cansat-tsniimash/CanSat-KT315-2022/Documents/Models/Frames/tip-open_0070.jpg

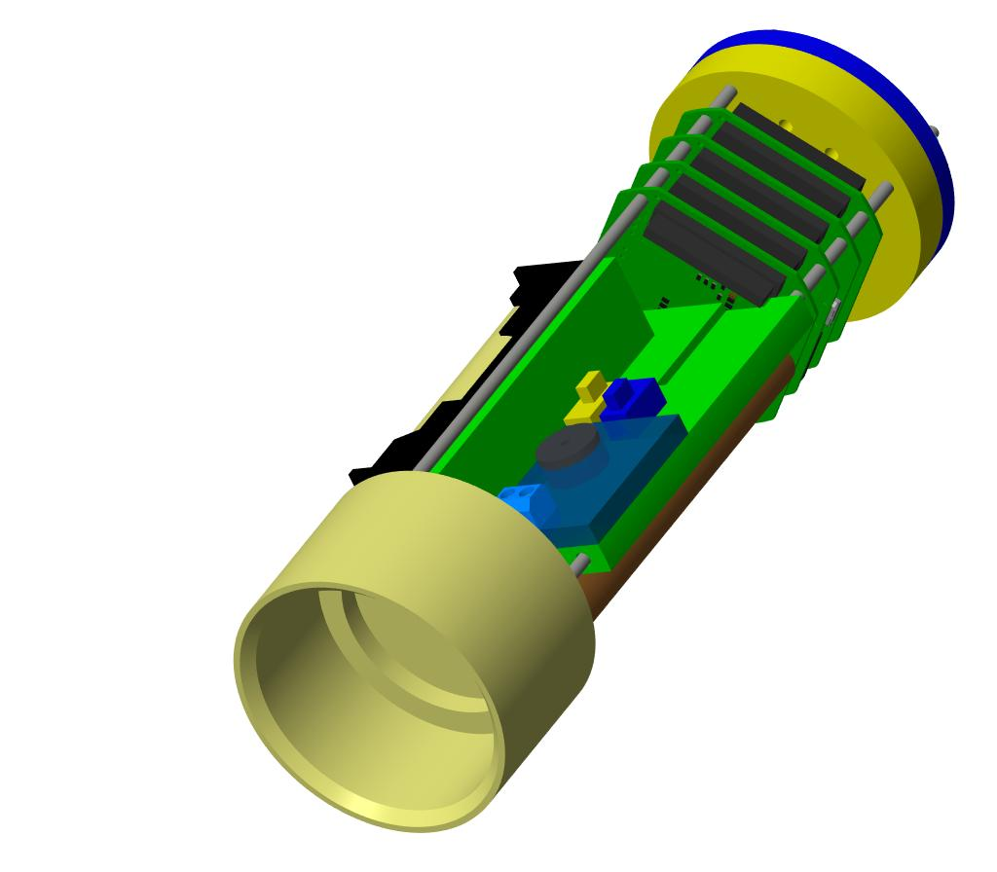
Documents/Models/Frames/tip-open_0070.jpg
