cansat-tsniimash/CanSat-KT315-2022/Documents/Session/onewire_.pdf

# Обмен цифровой информацией

# Шины и интерфейсы

## Знакомство с инструментами и мигание лампочкой

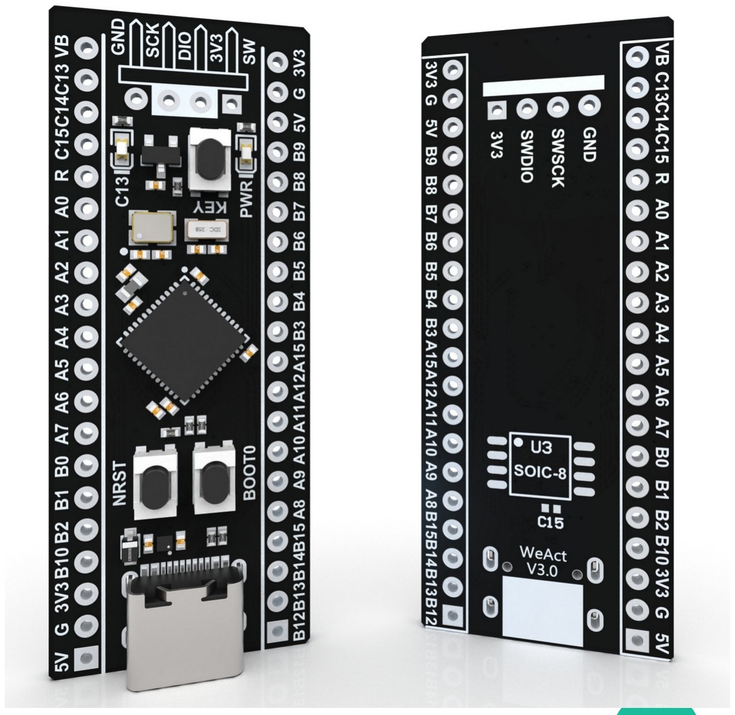
[picture p2: figure]

3

# Плата WeActTC/MiniSTM32F4x1

# - У нас вариант с STM32F411CEU6 на борту - Плата имеет документацию! https://github.com/WeActTC/ MiniSTM32F4x1 (https://github.com/WeActTC/MiniSTM32F4x1)

# Что есть на плате

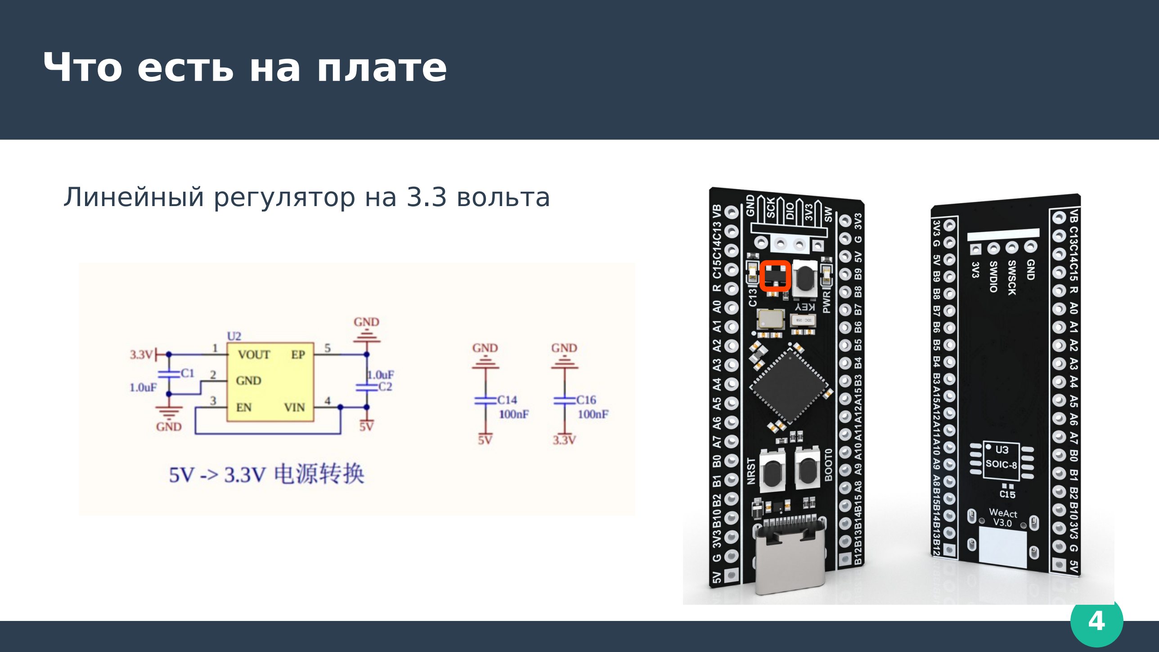
[picture p3: page 4]

4

# Линейный регулятор на 3.3 вольта

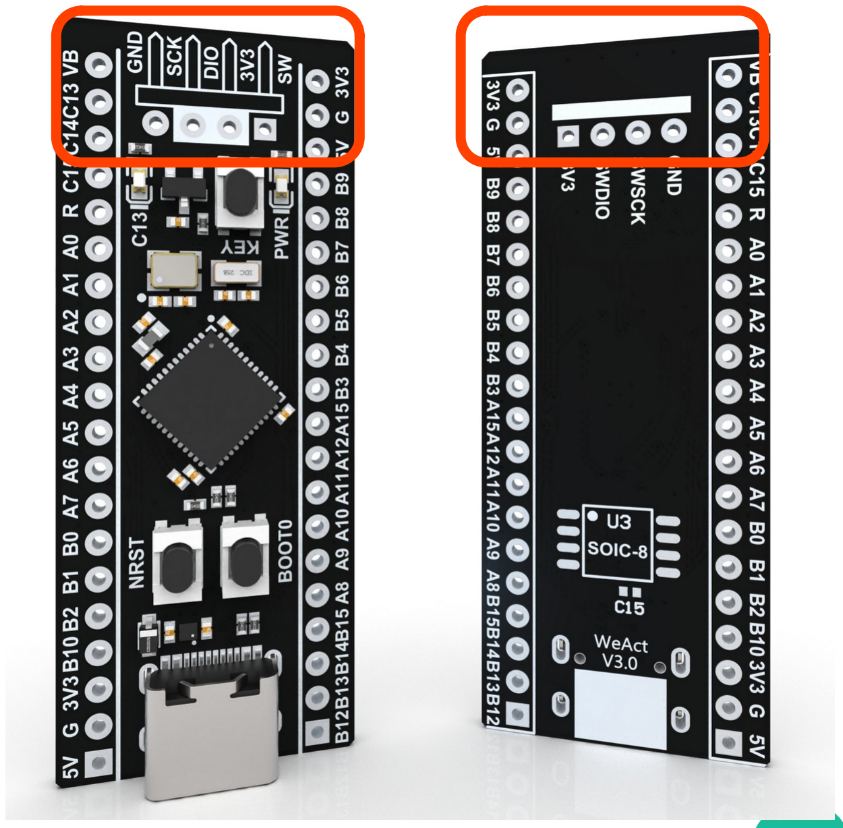
[picture p4: figure]

5

# Что есть на плате

# Разъем для программатора (Serial Wire Debug = SWD)

# 3V3 — питание 3.3В GND — нулевой провод (земля) SCK — синхросигнал SWD DIO — данные SWD

# Что есть на плате

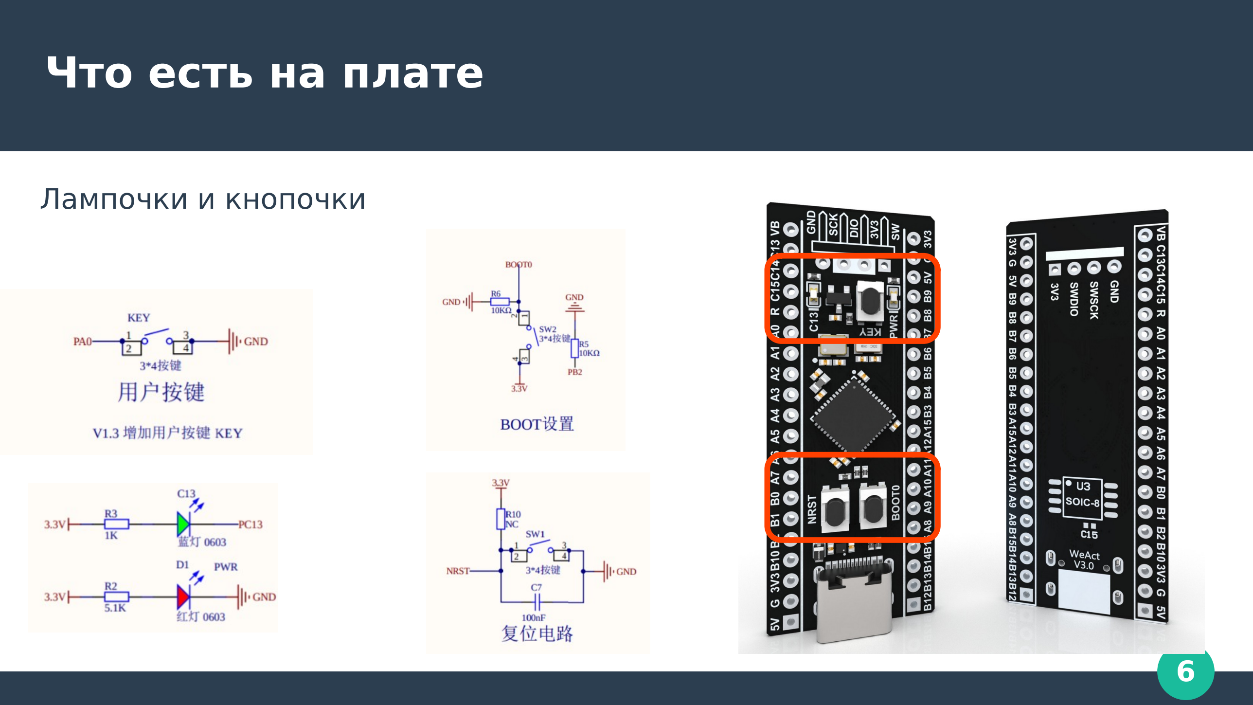
[picture p5: page 6]

6

# Лампочки и кнопочки

# Что есть на плате

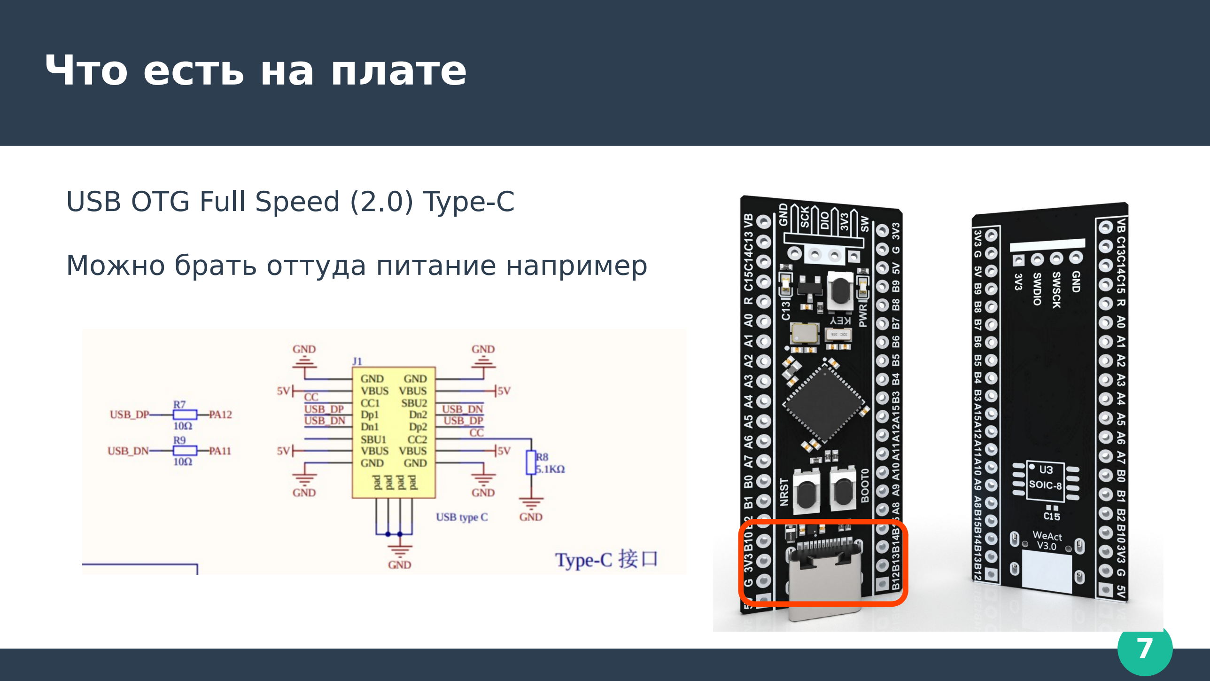
[picture p6: page 7]

7

# USB OTG Full Speed (2.0) Type-C

# Можно брать оттуда питание например

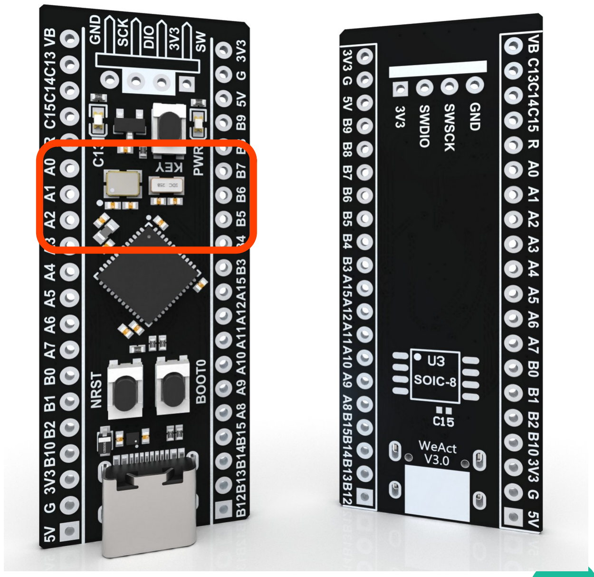
[picture p7: figure]

8

# Что есть на плате

# Кварцевые резонаторы

# HSE (High Speed External) на 25 МГц LSE (Low Speed External) на 32.768 КГц

# Что есть на плате

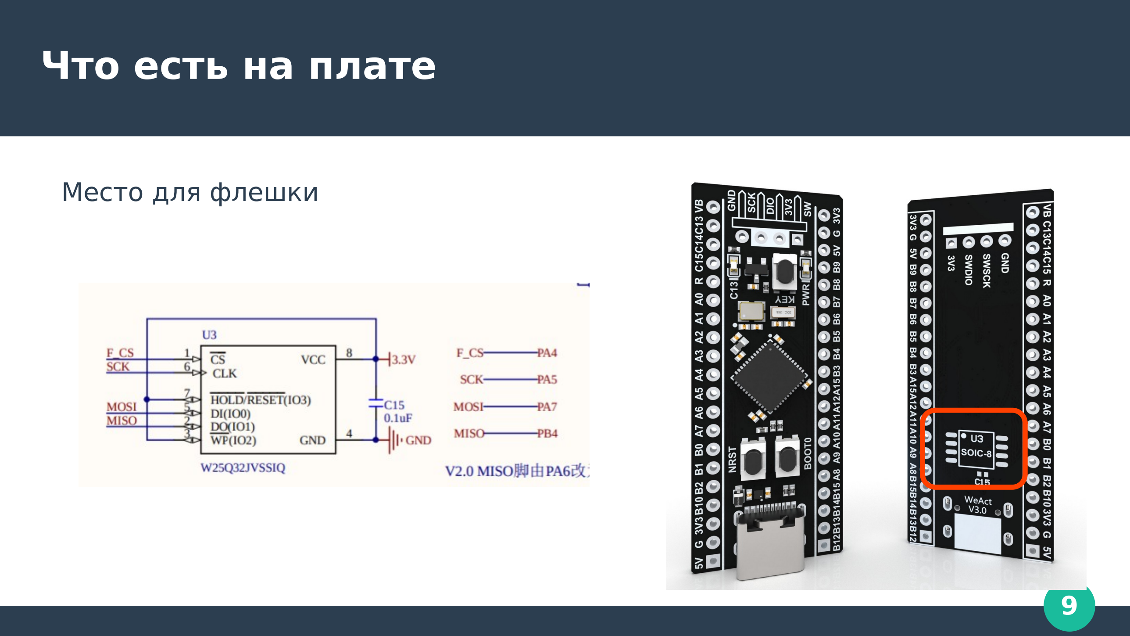
[picture p8: page 9]

9

# Место для флешки

10

# STM32CubeIDE

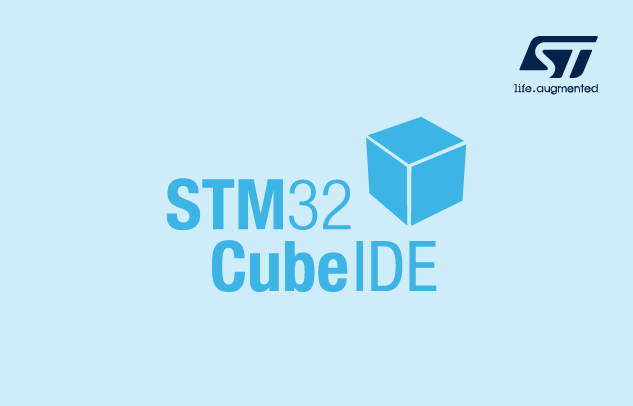
[picture p9: figure]

11

# Создание проекта

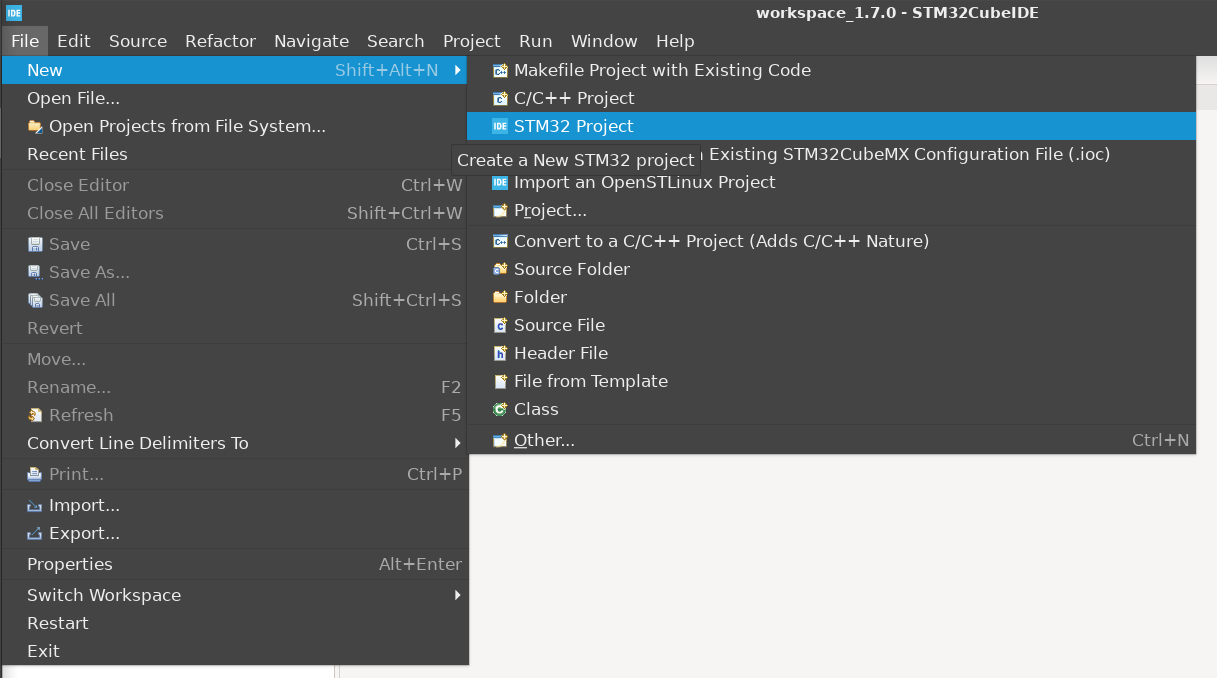
[picture p10: figure]

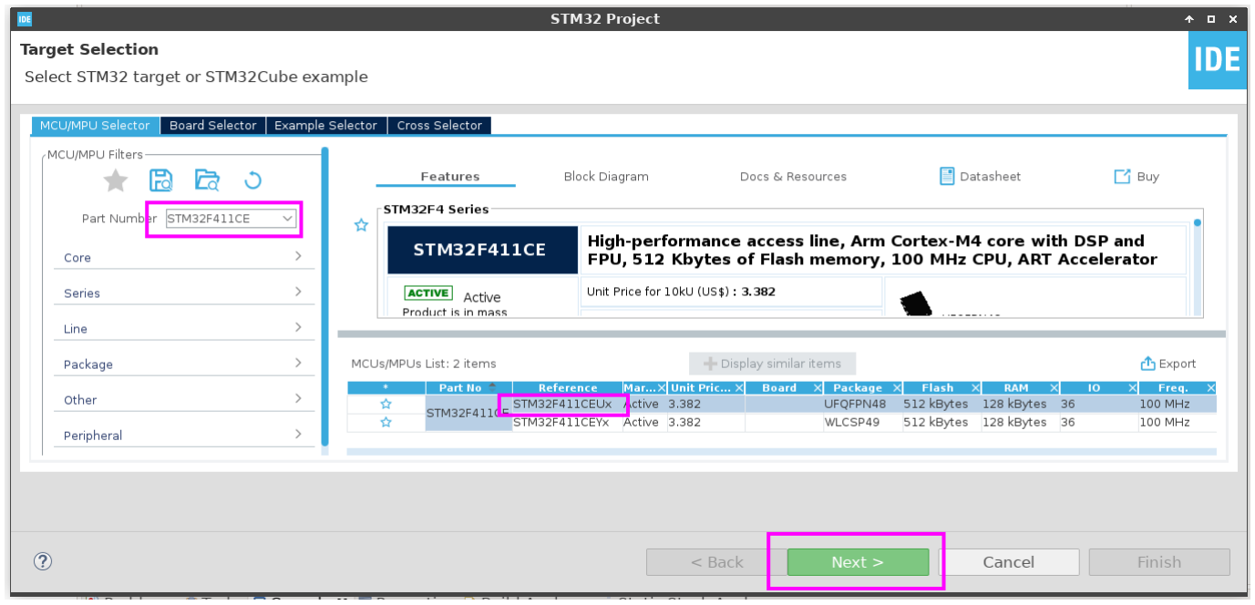
[picture p11: figure]

12

# Создание проекта

# Создание проекта

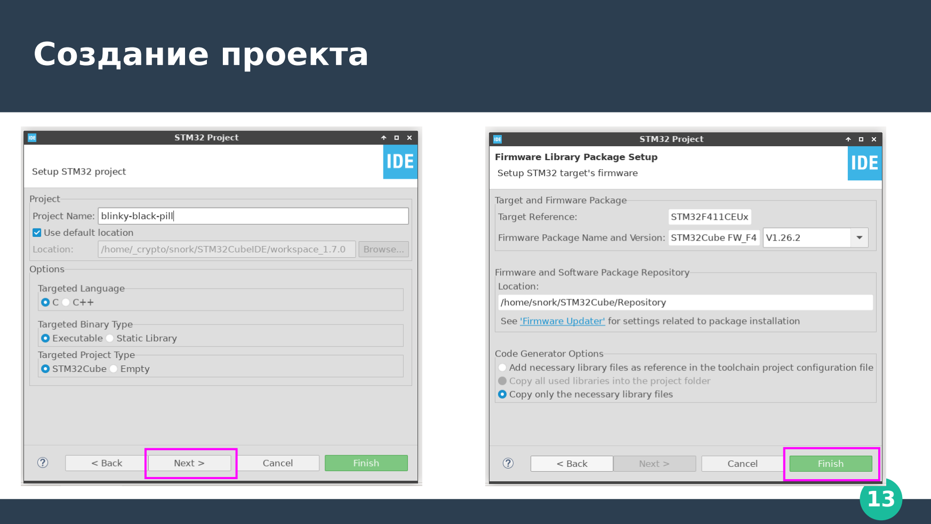
[picture p12: page 13]

13

14

# Обзор проекта

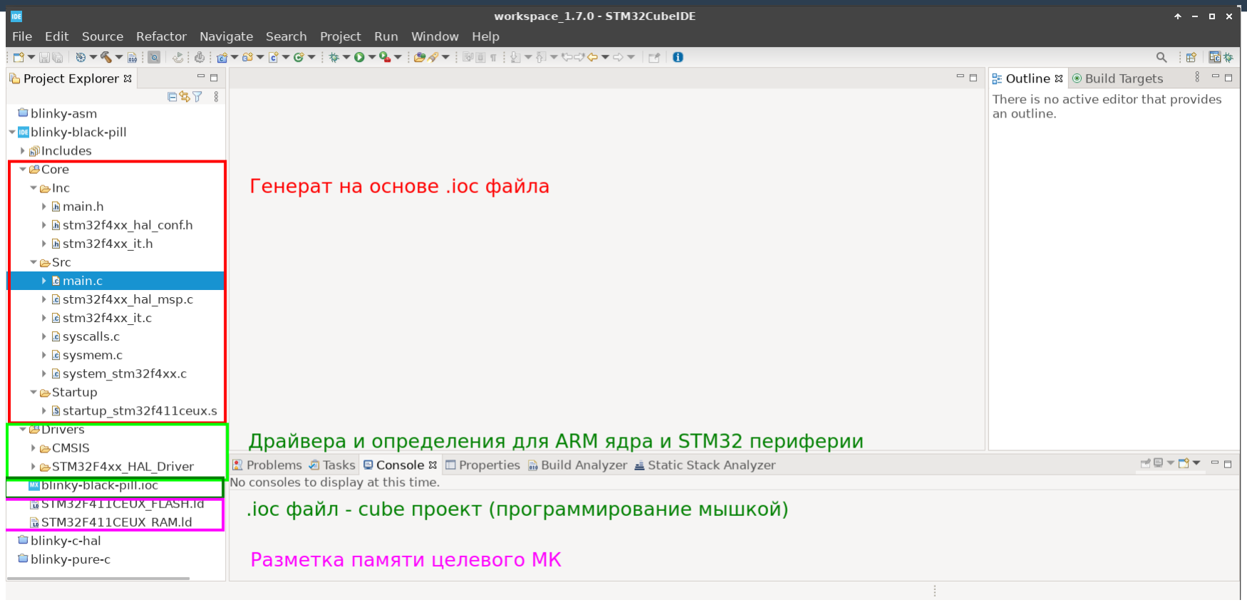
[picture p13: figure]

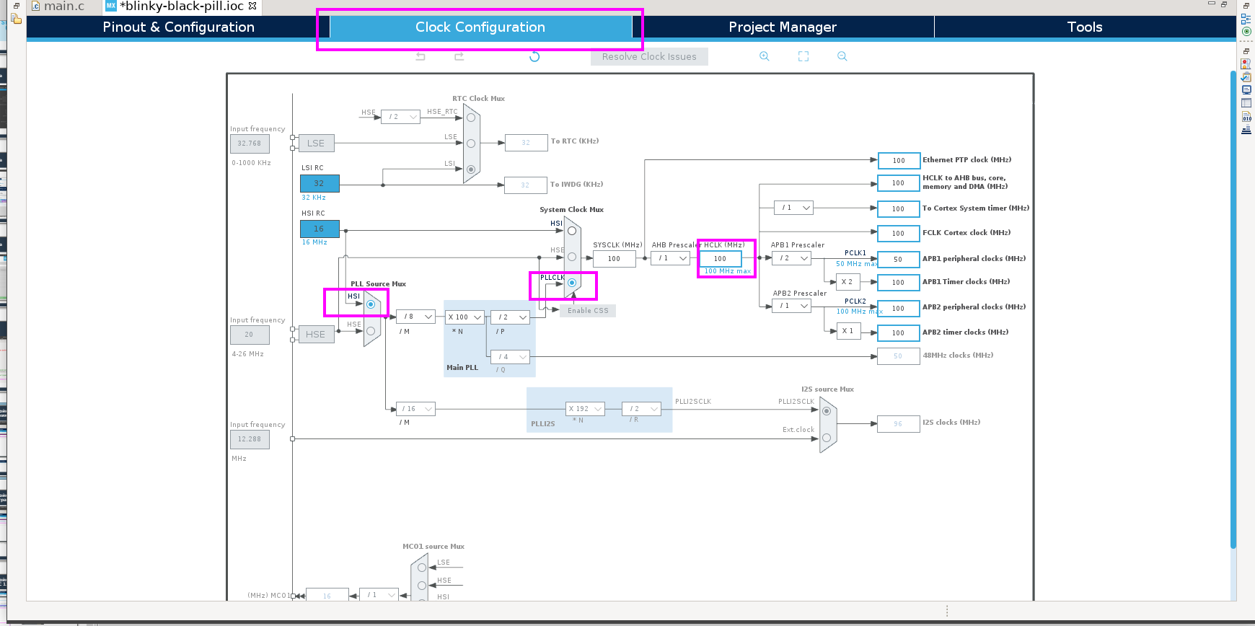
[picture p14: figure]

15

# Первичная настройка Cube (.ioc) проекта Настройка частот

16

# Первичная настройка Cube (.ioc) проекта Разрешение программатора

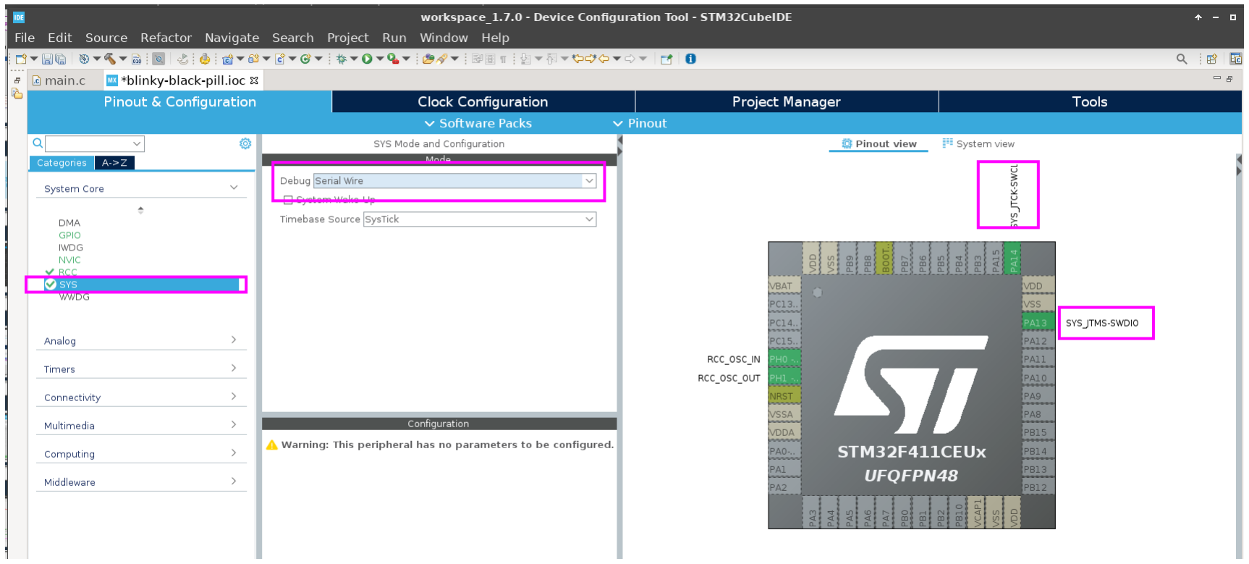
[picture p15: figure]

# Первичная настройка Cube (.ioc) проекта Настройка GPIO C 13

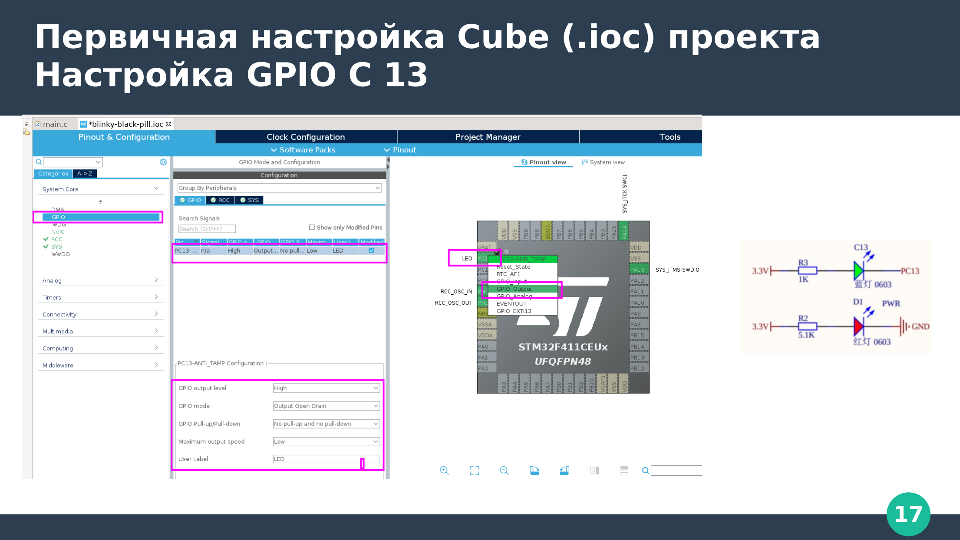
[picture p16: page 17]

17

# Push Pull / Open Drain

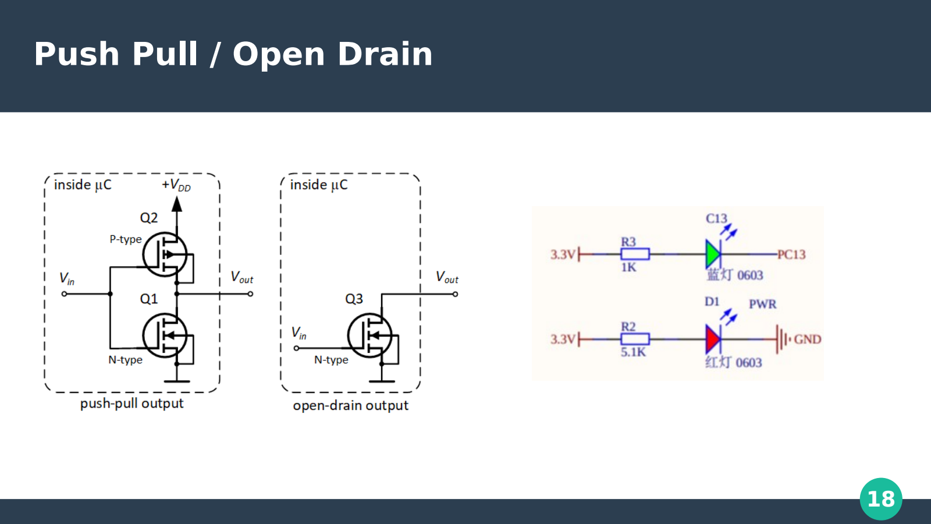
[picture p17: page 18]

18

# Обновление генерата

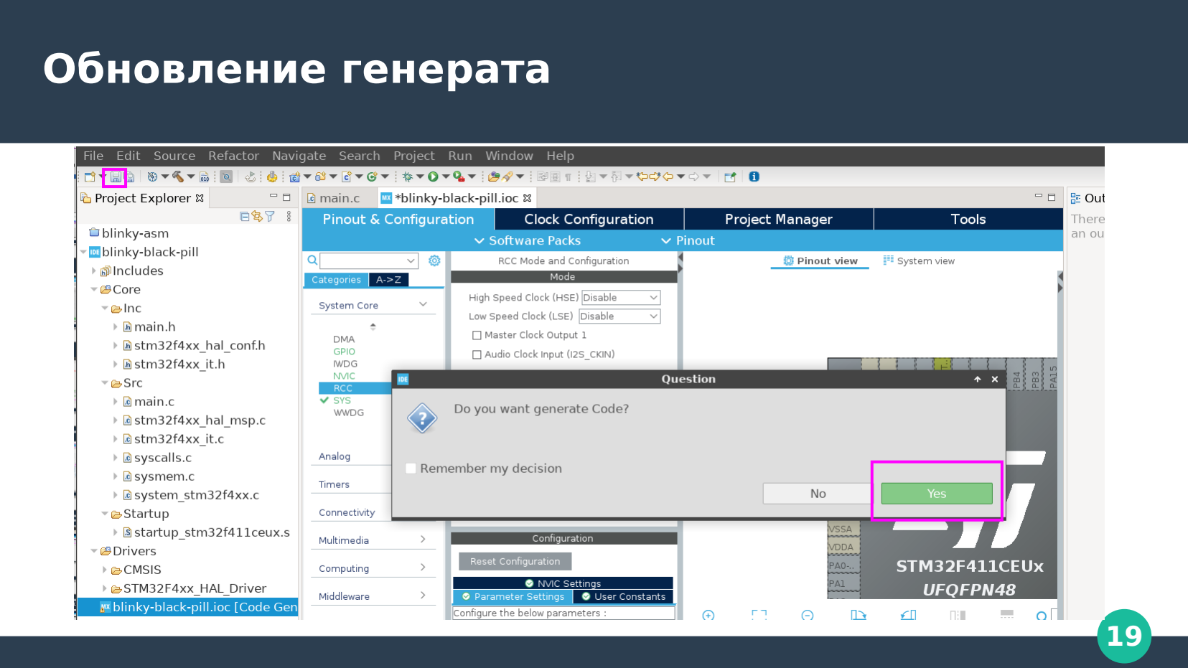
[picture p18: page 19]

19

20

# Функция main()

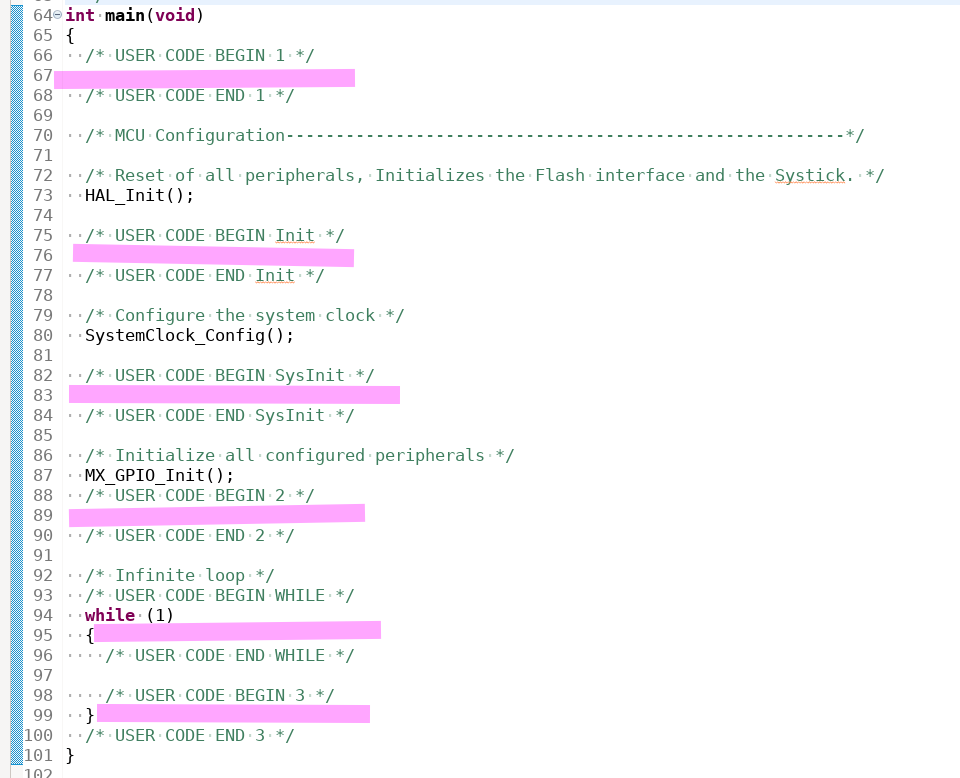
[picture p19: figure]

# Состоит из инициализации железа и бесконечного цикла

21

# Функции для работы с GPIO

Вообще, документация для HAL живёт тут, (https://www.st.com/resource/en/user_manual/dm00105879-description-of-stm32f4-hal-and-ll-drivers-stmicroelectronics.pdf) но это большой и сложный

# документ. Почти все что в нем написано — написано и в исходниках

/* Initialization and de-initialization functions *****************************/
void HAL_GPIO_Init(GPIO_TypeDef *GPIOx, GPIO_InitTypeDef *GPIO_Init);
void HAL_GPIO_DeInit(GPIO_TypeDef *GPIOx, uint32_t GPIO_Pin);

/* IO operation functions *****************************************************/ GPIO_PinState HAL_GPIO_ReadPin(GPIO_TypeDef* GPIOx, uint16_t GPIO_Pin);
void HAL_GPIO_WritePin(GPIO_TypeDef* GPIOx, uint16_t GPIO_Pin, GPIO_PinState PinState); void HAL_GPIO_TogglePin(GPIO_TypeDef* GPIOx, uint16_t GPIO_Pin);

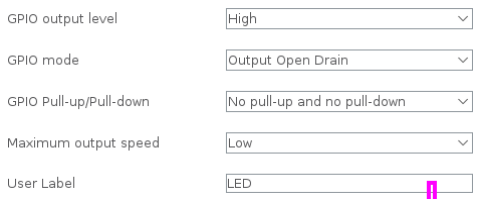
[picture p20: figure]

22

# Что нагенерил cube для инициализации?

static void MX_GPIO_Init(void)
{
GPIO_InitTypeDef GPIO_InitStruct = {0};

/* GPIO Ports Clock Enable */ __HAL_RCC_GPIOC_CLK_ENABLE(); __HAL_RCC_GPIOA_CLK_ENABLE();

/*Configure GPIO pin Output Level */ HAL_GPIO_WritePin(LED_GPIO_Port, LED_Pin, GPIO_PIN_SET);

/*Configure GPIO pin : LED_Pin */
GPIO_InitStruct.Pin = LED_Pin;
GPIO_InitStruct.Mode = GPIO_MODE_OUTPUT_OD; GPIO_InitStruct.Pull = GPIO_NOPULL; GPIO_InitStruct.Speed = GPIO_SPEED_FREQ_LOW; HAL_GPIO_Init(LED_GPIO_Port, &GPIO_InitStruct);

}

/* Private defines -----------------------------------------------------------*/ #define LED_Pin GPIO_PIN_13
#define LED_GPIO_Port GPIOC

# Фаил main.h

# Фаил main.c

23

# Мигаем лампочкой

/* Infinite loop */
/* USER CODE BEGIN WHILE */ while (1)
{
// Зажигаем лампочку
HAL_GPIO_WritePin(GPIOC, GPIO_PIN_13, GPIO_PIN_RESET); // Ждем 1000 миллисекунд
HAL_Delay(1000);
// Тушим лампочку
HAL_GPIO_WritePin(LED_GPIO_Port, LED_Pin, GPIO_PIN_SET); // Ждем 500 миллисекунд
HAL_Delay(500);
/* USER CODE END WHILE */

/* USER CODE BEGIN 3 */
}
/* USER CODE END 3 */

# Фаил main.c функция main(void)

# Сборка проекта

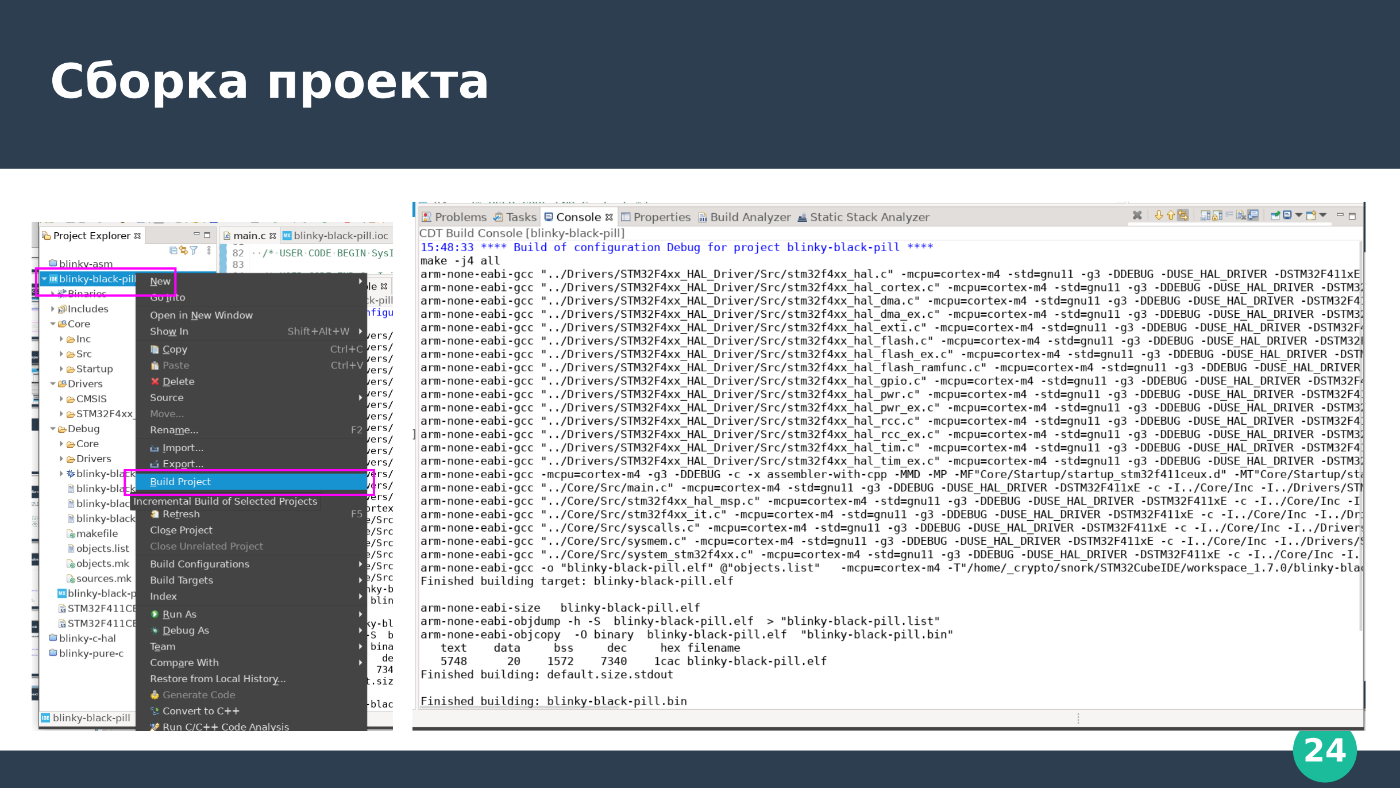
[picture p21: page 24]

24

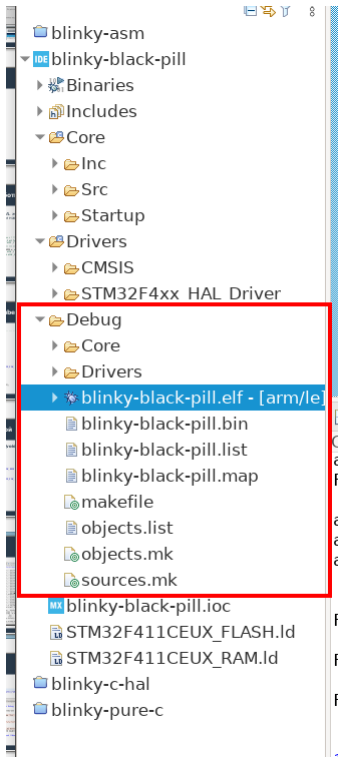
[picture p22: figure]

25

# Результаты сборки

# .elf файл — Executable and Linkable Format

Формат .exe файла для POSIX платформ.

# Содержит все необходимое для запуска и отладки проекта

# .bin — образ флеш памяти целевого МК

# .list — asm листинг получившегося кода

# .map — файл-карта. Показывает в какие регионы памяти попали разные функции и переменные

26

# Cборка проекта неудачный билд

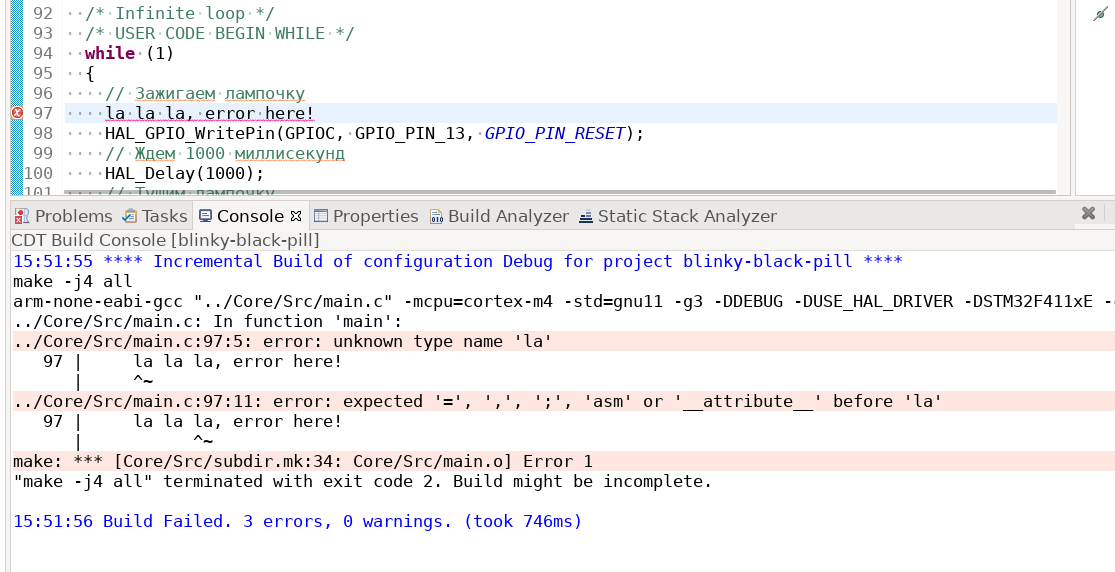
[picture p23: figure]

27

# Прошивка проекта Создание конфигурации запуска

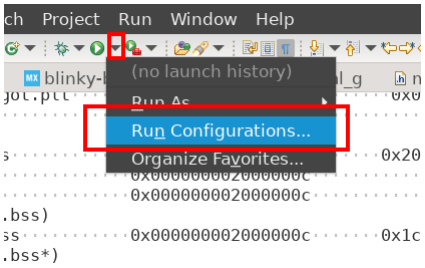
[picture p24: figure]

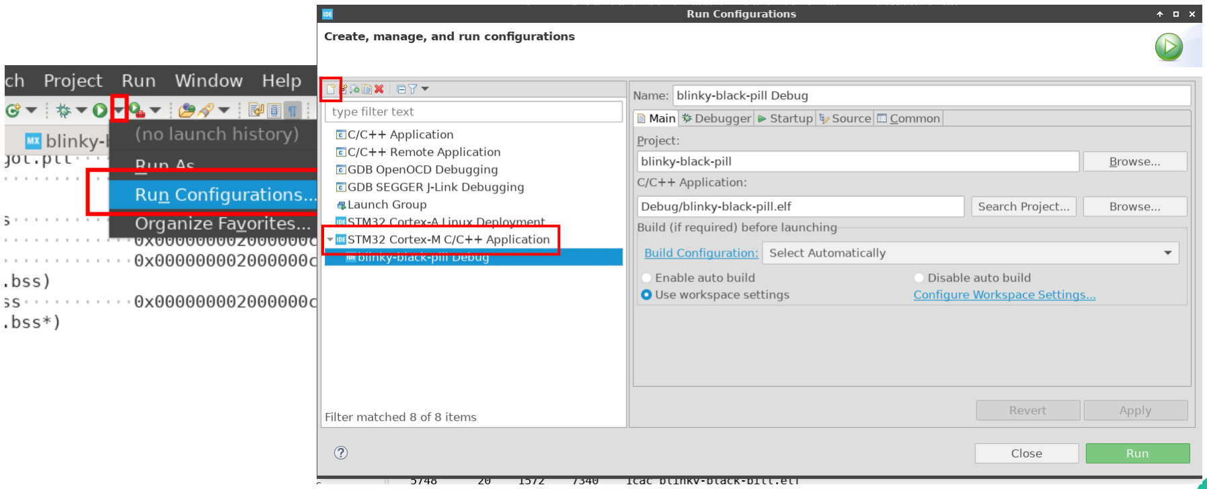
[picture p25: figure]

28

# Прошивка проекта Создание конфигурации запуска

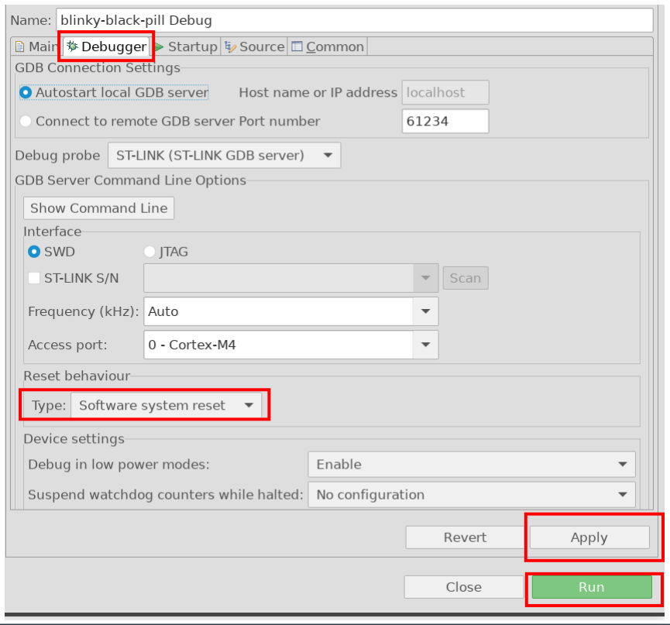
[picture p26: figure]

29

# Прошика проекта Настройка конфигурации запуска

# Прошивка проекта Подключение программатора и запуск

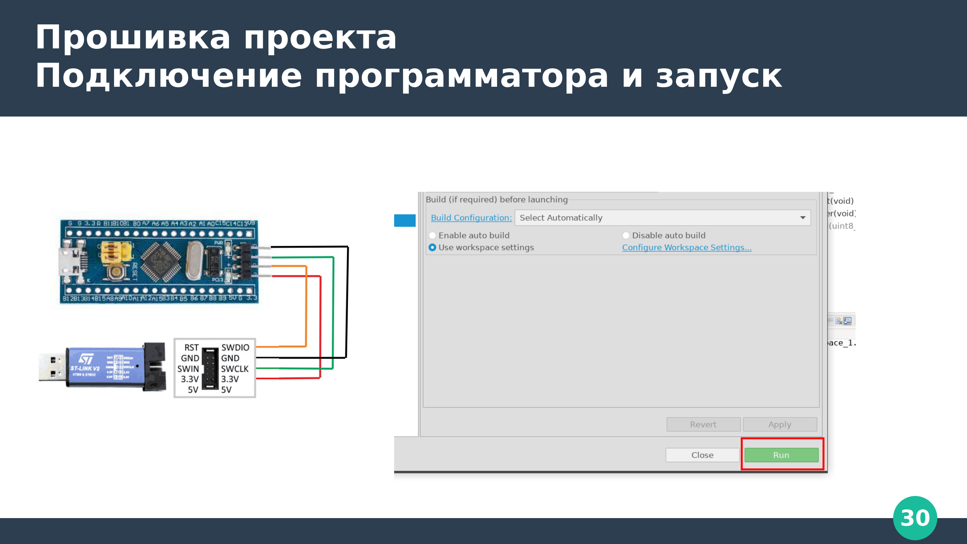
[picture p27: page 30]

30

## Делаем себе консоль

32

# UART

# Universal asynchronous receiver-transmitter

# Асинхронный интерфейс

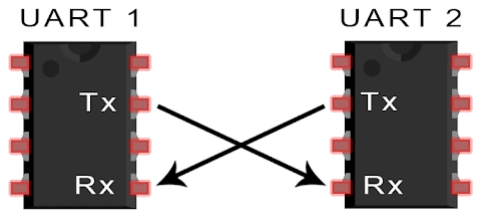
[picture p28: figure]

# Позволяет связать два равноправных устройства

# Достаточно быстрый

# Очень распространённый

33

# UART

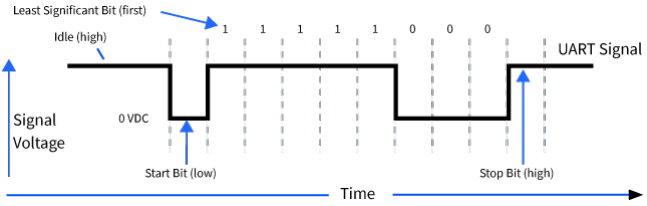
[picture p29: figure]

34

# UART Baud Rate

# Baud Rate это частота изменения сигнала. Показывает сколько

«символов» в секунду передается посредством интерфейса. Типовые значения: 110, 300, 600, 1200, 2400, 4800, 9600, 14400, 19200, 38400, 57600, 115200, 128000 и 256000

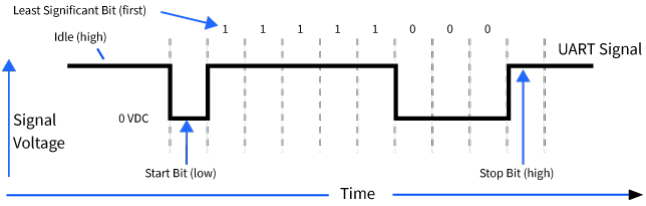
[picture p30: figure]

35

# UART Word size

# В этом примере передаётся 8 бит за один «фрейм». Некоторые

устройства передают большее или меньшее количество бит за фрейм.

# UART Parity

# Возможно использование специального «бита чётности». Этот бит

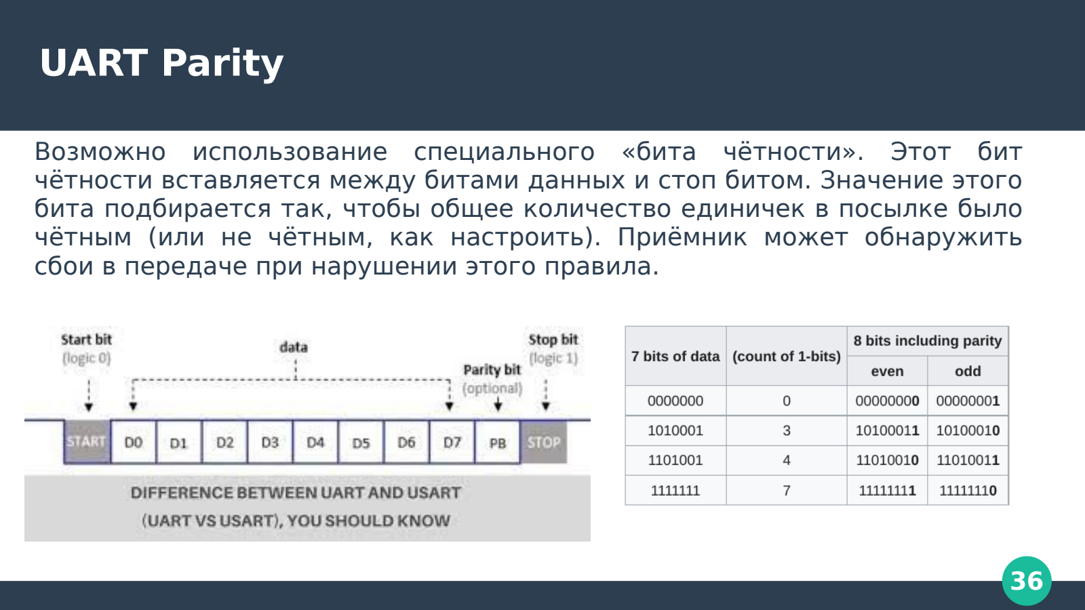
[picture p31: page 36]

36

# чётности вставляется между битами данных и стоп битом. Значение этого бита подбирается так, чтобы общее количество единичек в посылке было чётным (или не чётным, как настроить). Приёмник может обнаружить

сбои в передаче при нарушении этого правила.

37

# UART Stop Bits

# В этом примере используется 1 стоп бит. Некоторые устройства используют несколько стоп битов

38

# В нашем stm32 есть аж 3 U(S)ART модуля периферии

# Включаем U(S)ART1

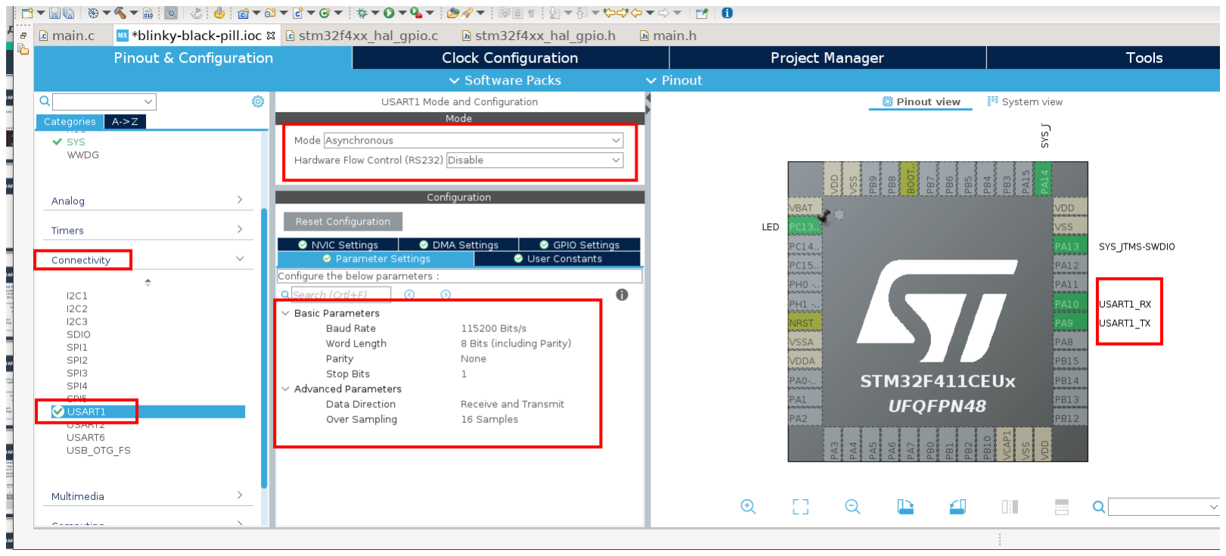
[picture p32: figure]

39

# API для работы с U(S)ART

# API для работы с U(S)ART

/* Initialization/de-initialization functions **********************************/ HAL_StatusTypeDef HAL_UART_Init(UART_HandleTypeDef *huart);

HAL_StatusTypeDef HAL_HalfDuplex_Init(UART_HandleTypeDef *huart);
HAL_StatusTypeDef HAL_LIN_Init(UART_HandleTypeDef *huart, uint32_t BreakDetectLength);
HAL_StatusTypeDef HAL_MultiProcessor_Init(UART_HandleTypeDef *huart, uint8_t Address, uint32_t WakeUpMethod); HAL_StatusTypeDef HAL_UART_DeInit(UART_HandleTypeDef *huart);

/* IO operation functions *******************************************************/
HAL_StatusTypeDef HAL_UART_Transmit(UART_HandleTypeDef *huart, uint8_t *pData, uint16_t Size, uint32_t Timeout); HAL_StatusTypeDef HAL_UART_Receive(UART_HandleTypeDef *huart, uint8_t *pData, uint16_t Size, uint32_t Timeout);

HAL_StatusTypeDef HAL_UART_Transmit_IT(UART_HandleTypeDef *huart, uint8_t *pData, uint16_t Size);
HAL_StatusTypeDef HAL_UART_Receive_IT(UART_HandleTypeDef *huart, uint8_t *pData, uint16_t Size);
HAL_StatusTypeDef HAL_UART_Transmit_DMA(UART_HandleTypeDef *huart, uint8_t *pData, uint16_t Size);
HAL_StatusTypeDef HAL_UART_Receive_DMA(UART_HandleTypeDef *huart, uint8_t *pData, uint16_t Size);

40

# Отправляем hello world

/* USER CODE BEGIN 2 */
const char string[] = "Hello world!\n"; /* USER CODE END 2 */

/* Infinite loop */
/* USER CODE BEGIN WHILE */
while (1)
{
// Зажигаем лампочку
HAL_GPIO_WritePin(GPIOC, GPIO_PIN_13, GPIO_PIN_RESET); // Ждем 1000 миллисекунд
HAL_Delay(1000);
// Тушим лампочку
HAL_GPIO_WritePin(LED_GPIO_Port, LED_Pin, GPIO_PIN_SET); // Ждем 500 миллисекунд
HAL_Delay(500);

// Отправляем хеллоу ворлд
HAL_UART_Transmit(&huart1, string, sizeof(string)-1, HAL_MAX_DELAY);

/* USER CODE END WHILE */

/* USER CODE BEGIN 3 */
}
/* USER CODE END 3 */

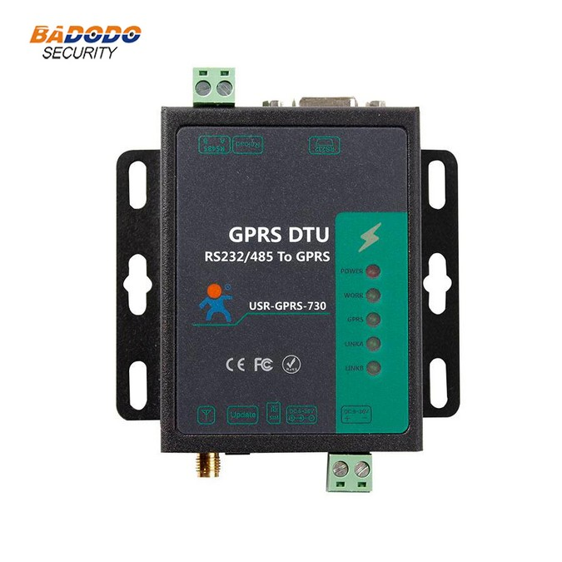
[picture p33: figure]

41

# Принимаем сообщение на ПК

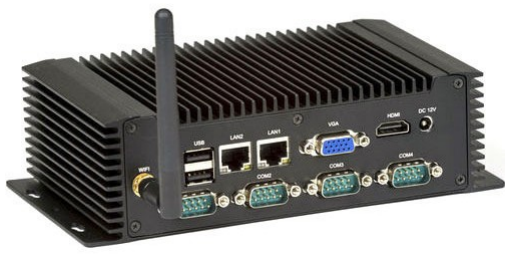
[picture p34: figure]

# RS-232 традиционно использовался на ПК для подключения различной

периферии.

# Сейчас он присутствует на многих материнских платах, но не выведен на корпус. На корпус он выведен в

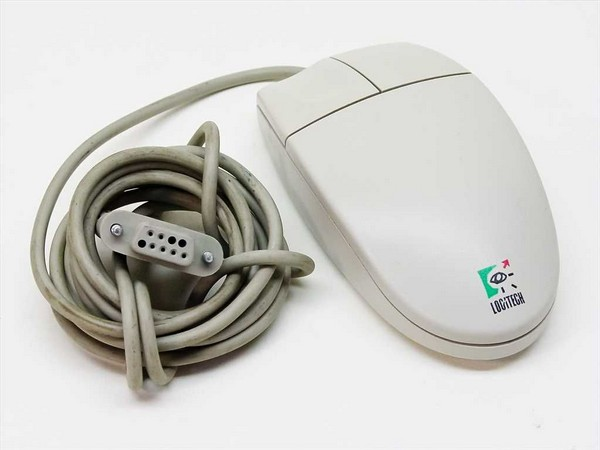
[picture p35: figure]

# промышленных ПК (например в кассовых аппаратах)

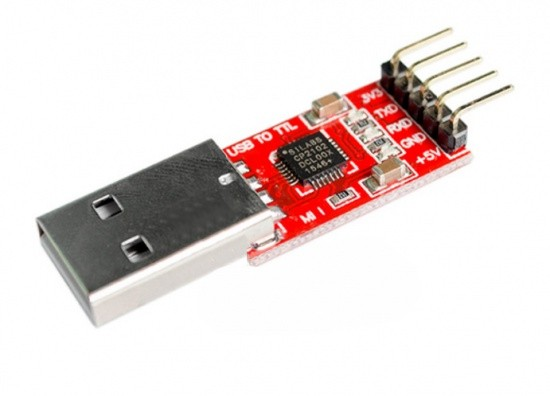
[picture p36: figure]

42

# USB-UART преобразователь

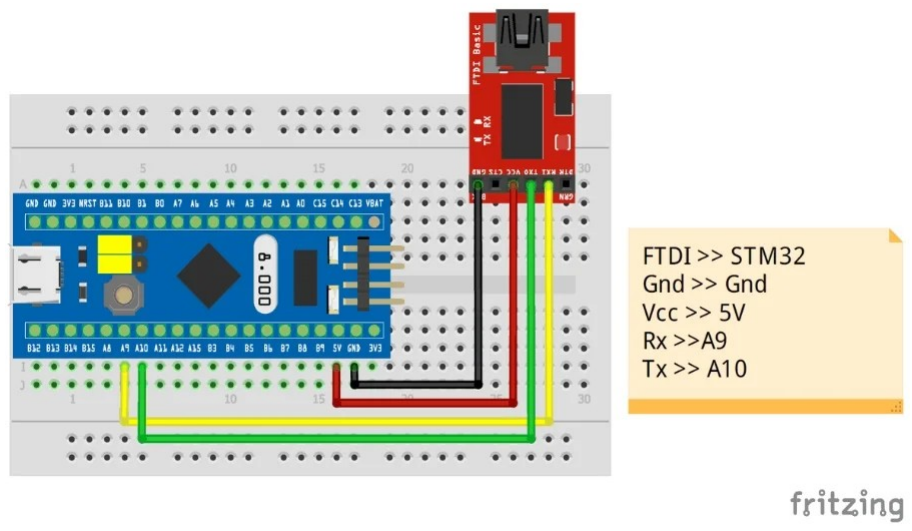
[picture p37: figure]

43

# Подключение к STM32

# Putty / minicom

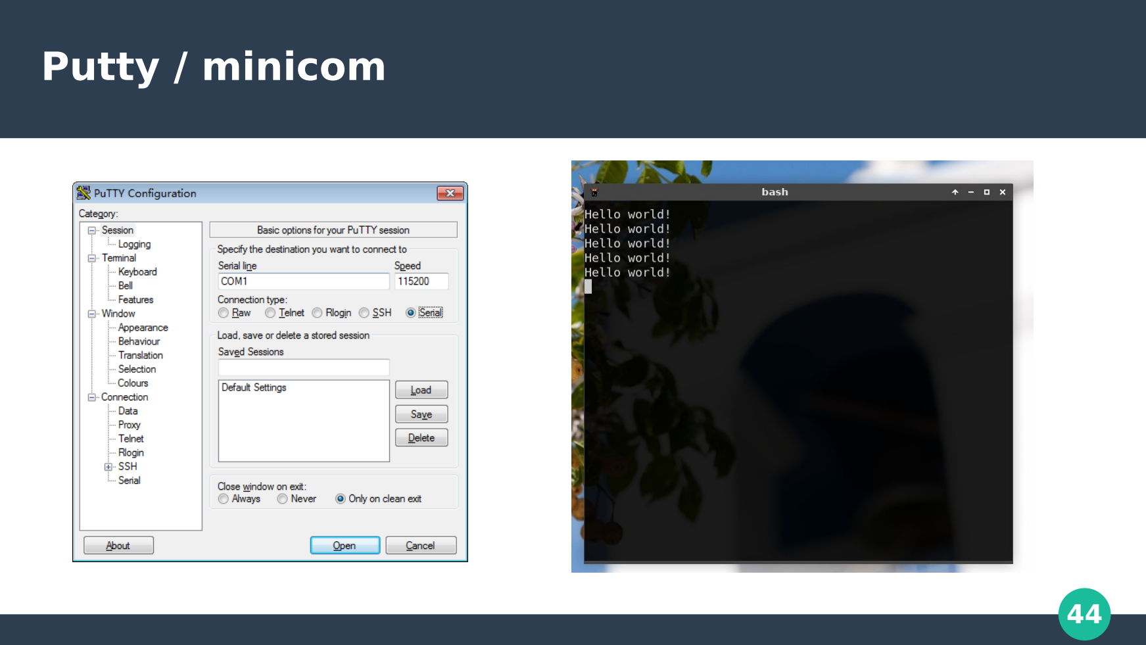
[picture p38: page 44]

44

# Использование UART вместе с printf

# Стандартная библиотека Си (newlib)

# Пользовательское приложение

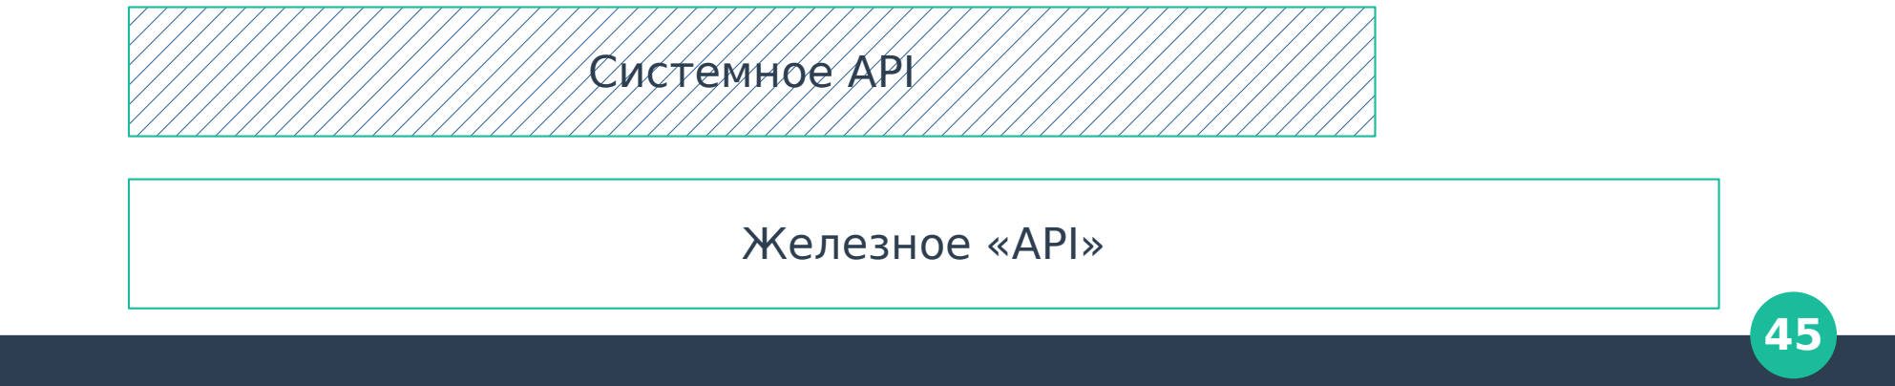
[picture p39: figure]
Системное API; Железное «API»

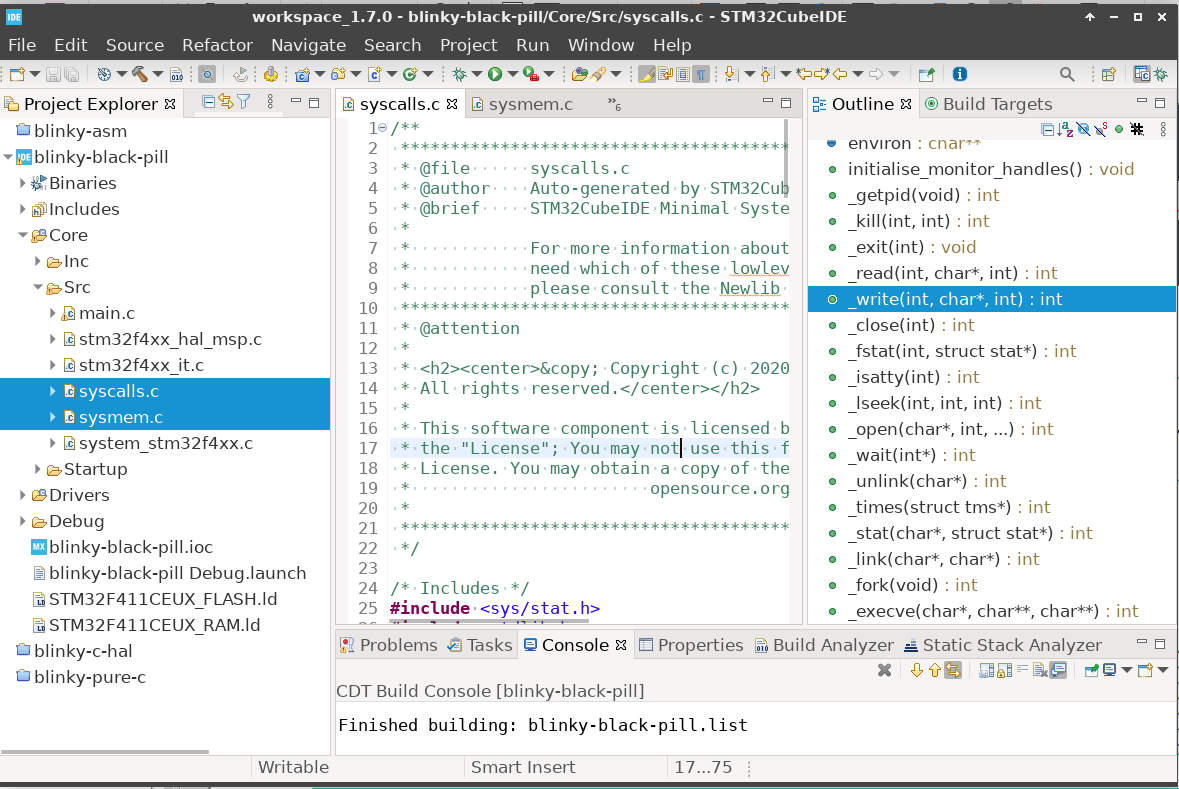
[picture p40: figure]

46

# Использование UART вместе с printf

int _write(int file, char *ptr, int len) {
/* … */
}

#include <stm32f4xx_hal.h>

int _write(int file, char *ptr, int len) {
extern UART_HandleTypeDef huart1;

HAL_UART_Transmit(
&huart1,
(uint8_t*)ptr, len,
HAL_MAX_DELAY
);

return len;
}

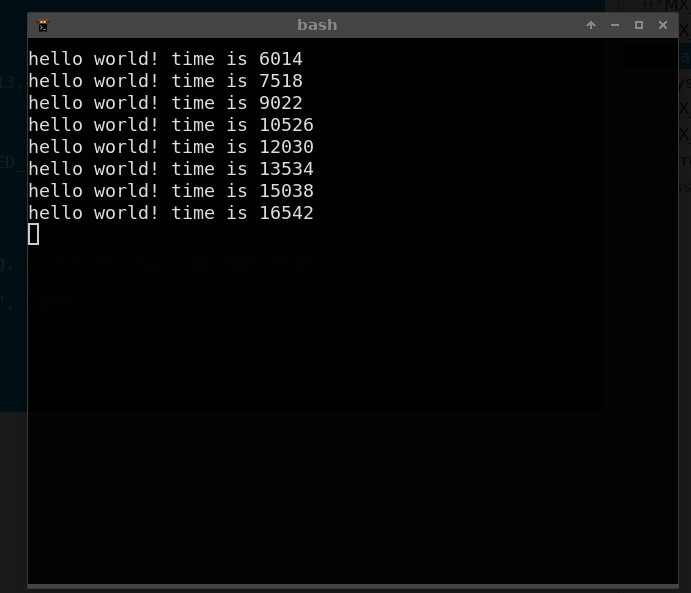
[picture p41: figure]

47

# Каноничный hello world

/* Private includes ----------------------------------------------------------*/ /* USER CODE BEGIN Includes */
#include <stdio.h>

/* USER CODE END Includes */ | /* USER CODE BEGIN WHILE */
| while (1)
| {
| // Зажигаем лампочку
| HAL_GPIO_WritePin(GPIOC, GPIO_PIN_13, GPIO_PIN_RESET);
| // Ждем 1000 миллисекунд
| HAL_Delay(1000);
| // Тушим лампочку
| HAL_GPIO_WritePin(LED_GPIO_Port, LED_Pin, GPIO_PIN_SET);
| // Ждем 500 миллисекунд
| HAL_Delay(500);
| // Отправляем хеллоу ворлд
| //HAL_UART_Transmit(&huart1, string, sizeof(string), HAL_MAX_DELAY);
| int32_t time = HAL_GetTick();
| printf("hello world! time is %ld\n", time);
| /* USER CODE END WHILE */
| /* USER CODE BEGIN 3 */
| }
| /* USER CODE END 3 */

## Шина OneWire

49

# Шина 1-Wire

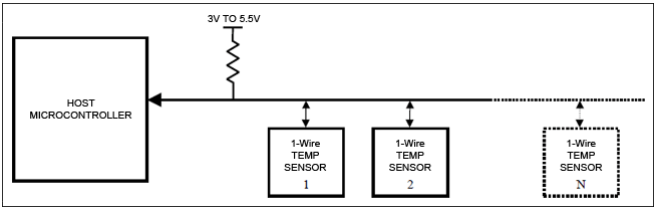
[picture p42: figure]

# Чумовой туториал на русском (https://aterlux.ru/article/1wire)

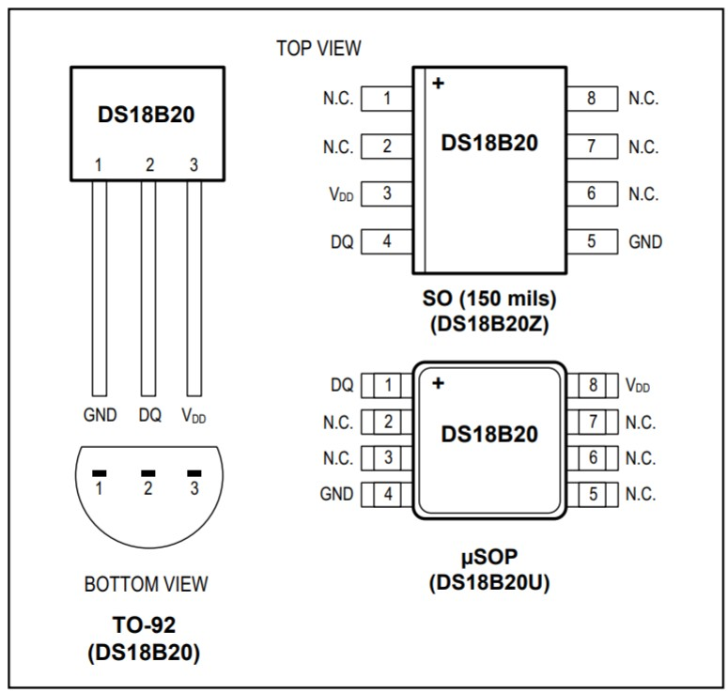
[picture p43: figure]

50

# DS18B20

# - Measures Temperatures from -55°C to

+125°C

- ±0.5°C Accuracy from -10°C to +85°C - Programmable Resolution from 9 Bits to 12 Bits - No External Components Required - Parasitic Power Mode Requires Only 2 Pins for operation (DQ and GND) - Flexible User-Definable Nonvolatile (NV) Alarm Settings with Alarm Search Command Identifies Devices with Temperatures Outside Programmed Limits

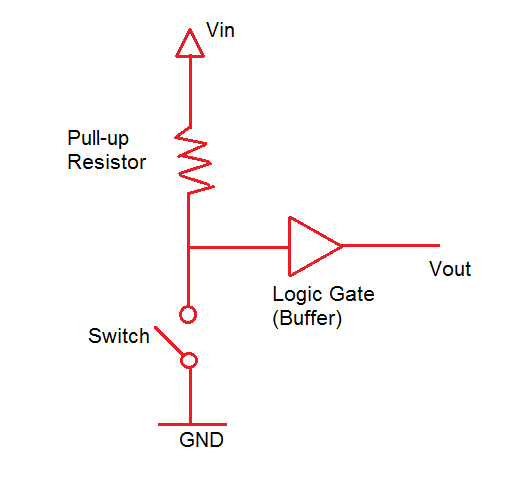
[picture p44: figure]

51

# Резистор подтяжки. 0 и 1 на шине

52

# Передача битиков от ведущего

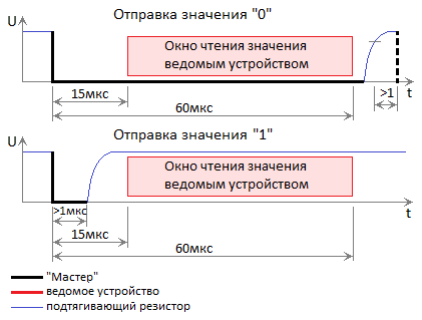
[picture p45: figure]

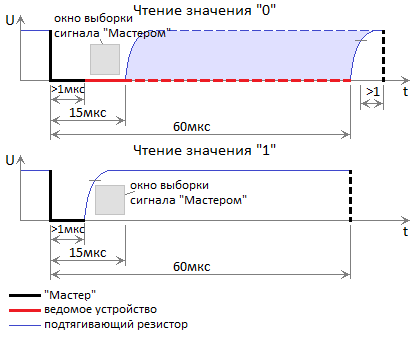
[picture p46: figure]

53

# Передача битиков от ведомого

54

# Этапы обмена

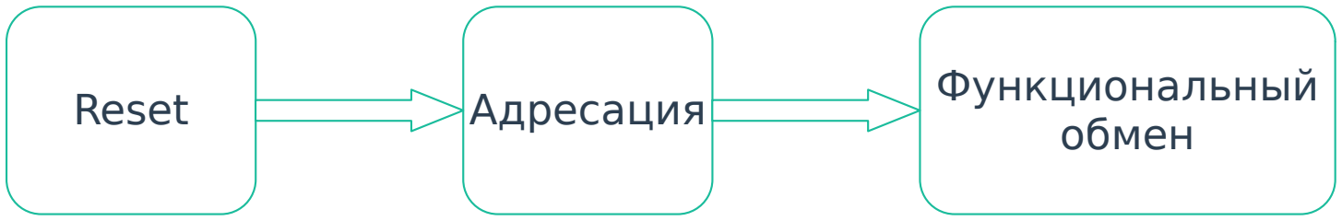
[picture p47: figure]
Reset; Адресация; Функциональный; обмен

55

# 1-wire reset

56

# Этап адресации

- У каждого устройства есть вшитый в него на фабрике 64-битный уникальный адрес - После reset команды наступает этап адресации - Команды этого этапа: 0xCC — skip rom - пропуск этапа адресации 0x33 — read rom - чтение адреса ведомого (если он один) 0x55 — match rom - выбор ведомого по указанному адресу 0xF0 — find rom - итеративное обнаружение всех ведомых на шине [0xEC — alarm search — эксклюзивная команда ds18b20 для поиска ведомых в состоянии «тревоги»]

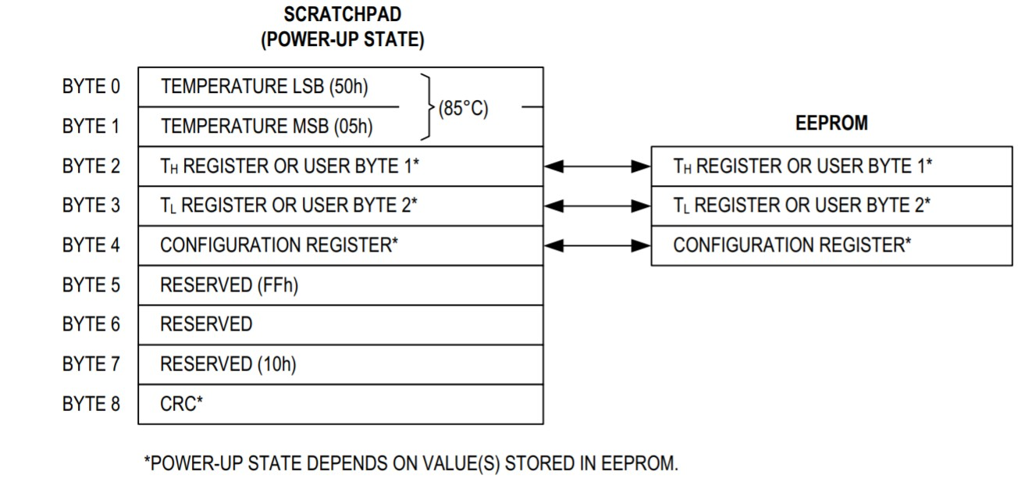
[picture p48: figure]

57

# Scratchpad

58

# Команды DS18B20

0x44 — convert T — начать замер температуры 0xEH — write scratchpad — принять значения для scratchpad с 1-wire шины 0xBE — read scratchpad — выдать значения из scratchpad на 1-wire шину 0x48 — copy scratchpad — сохранить значения из scratchpad в ПЗУ датчика 0x8H — recall — загрузить настройки в scratchpad из eeprom 0xB4 — read power supply — проверка режима питания

# Декомпозиция драйвера

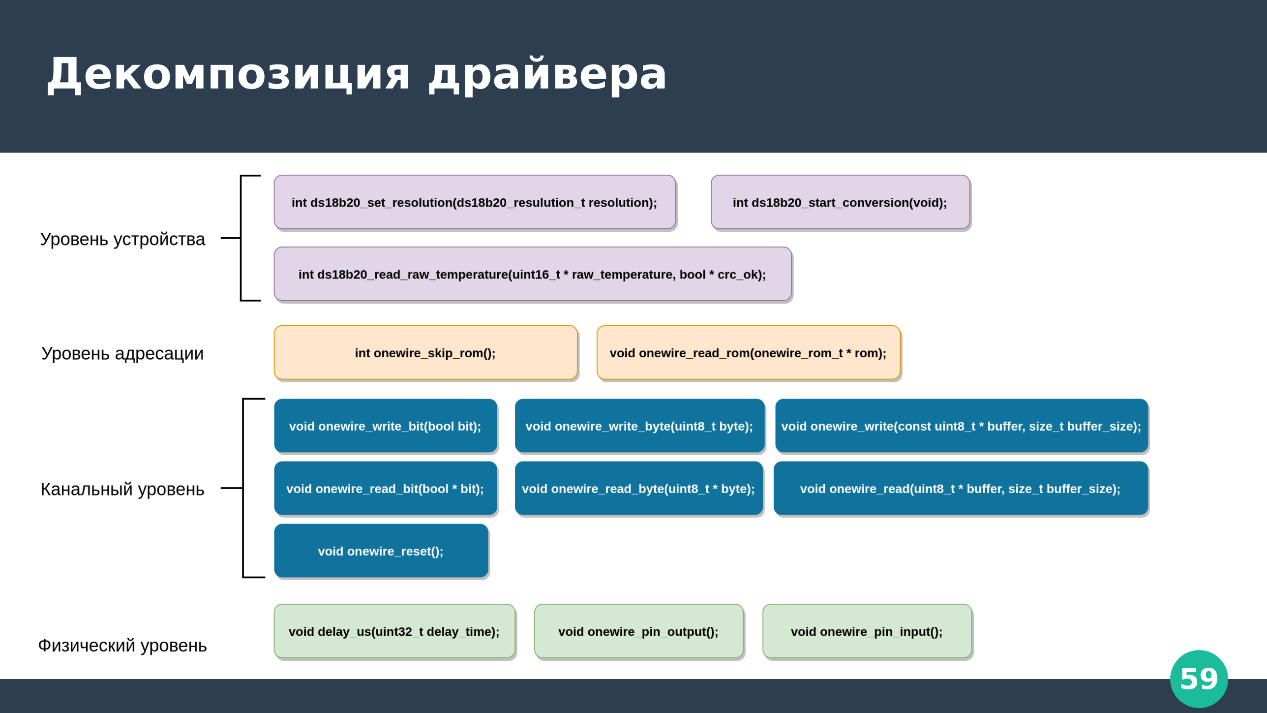
[picture p49: page 59]

59

# Подключение датчика

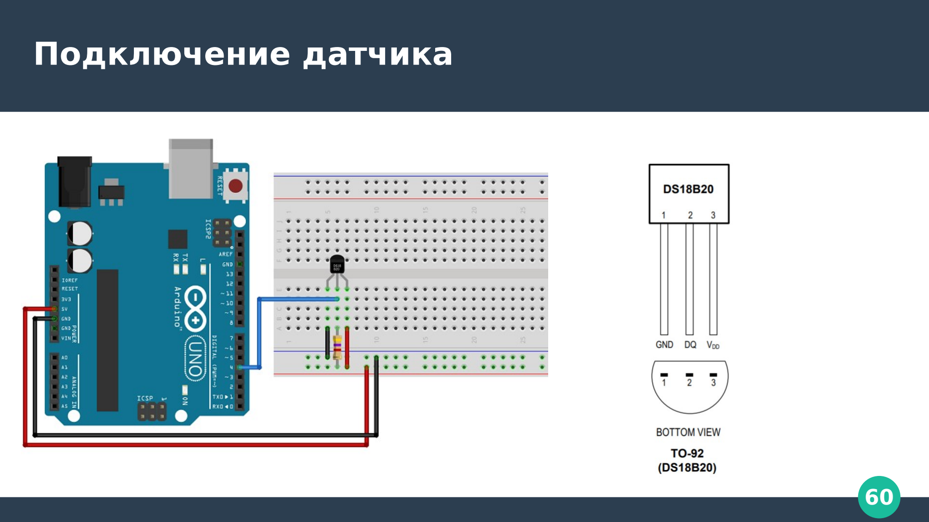
[picture p50: page 60]

60
