cansat-tsniimash/CanSat-KT315-2022/Documents/Docs/datasheets/!DemoPDF/Readme.txt

Если порядковый номер компонента (Designator) на схеме обозначен оранжевым цветом, то данный компонент не установлен на плату.
