cansat-tsniimash/CanSat-KT315-2022/Documents/Schemes/поджигатель.jpg

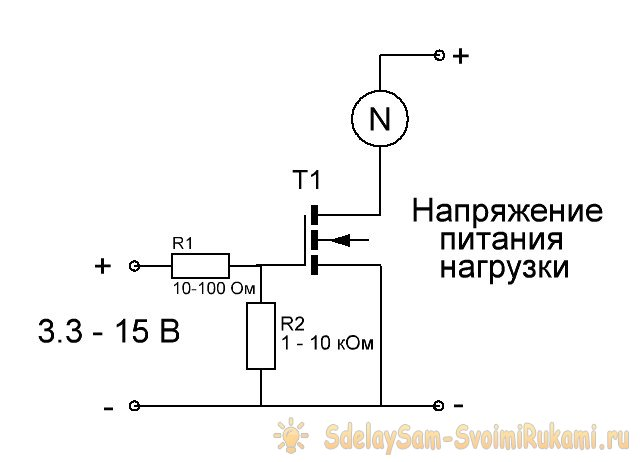
Documents/Schemes/поджигатель.jpg
