cansat-tsniimash/CanSat-KT315-2022/Documents/Session/Прототип-1 (анархо-коммунистический).png

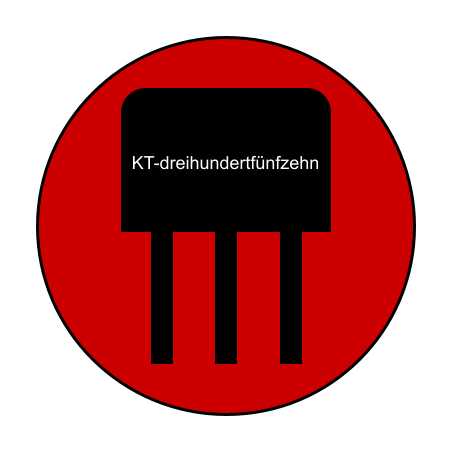
Documents/Session/Прототип-1 (анархо-коммунистический).png
