cansat-tsniimash/CanSat-KT315-2022/Documents/Models/trash/erunda.stl

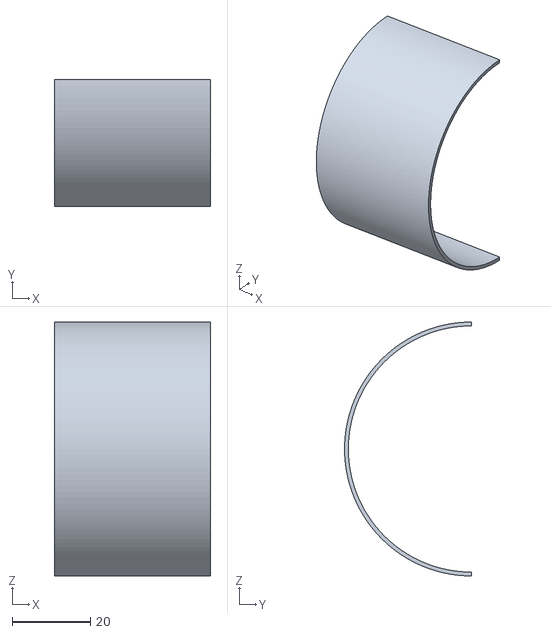
[picture p76: CAD file, 2022-07-02]
Documents/Models/trash/erunda.stl
40.0 x 32.5 x 65.0
