cansat-tsniimash/CanSat-KT315-2022/Telemetry/Madgwick watcher/model.stl

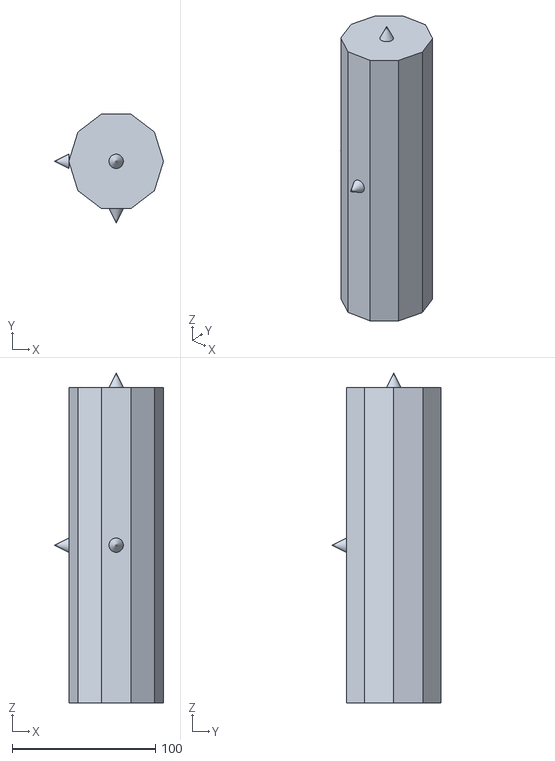
[picture p77: CAD file, 2022-07-07]
Telemetry/Madgwick watcher/model.stl
76.0 x 76.0 x 230.0
