cansat-tsniimash/CanSat-KT315-2022/Documents/Models/trash/panki_xoi.stl

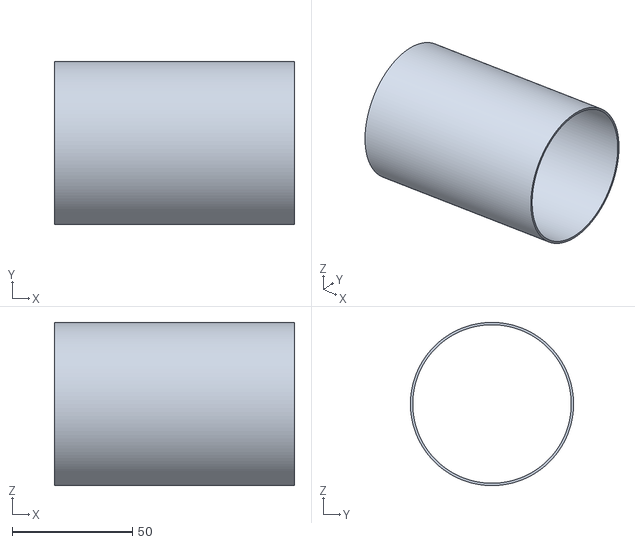
[picture p78: CAD file, 2022-07-02]
Documents/Models/trash/panki_xoi.stl
100.0 x 68.0 x 68.0
