cansat-tsniimash/CanSat-KT315-2022/Documents/Docs/constructor pinout.xlsx

Sheet: StolenByGogizh
RF-GNSS | MCU | PWR | IMU | SUPPLY | SPI | I2C | UART |  |  | RF-GNSS | MCU | PWR | IMU | SUPPLY | SPI | I2C | UART | 1-Wire
GND | GND | GND | GND | GND | SCK | SDA | RX | ADC | GND | GND | GND | GND | GND | GND | SCK | SDA | RX | ADC
N | PA4 | N | N | 3V3 | MISO | SCL | TX | PWM | PA4 |  |  |  |  | 3V3/5V/Vbat | MISO | SCL | TX | PWM
N | PA1 | N | 1W | 5V | MOSI | 1-Wire | CK | INT | PA1 | 1-Wire |  |  |  |  | MOSI |  | CK | INT
RF.AUX | PC3 | N | N | Vbat | NSS |  |  |  | PC3 | ADC |  |  |  |  | NSS
GND | GND | GND | GND |  |  |  |  |  | GND | GND | GND | GND | GND
RF.IRQ | PC2 | N | N |  |  |  |  |  | PC2 | ADC
N | PC13 | N | SR.OE |  |  |  |  |  | PC13 | SR-nOE
GND | GND | GND | GND |  |  |  |  |  | GND | GND | GND | GND | GND |  |  | СВОБОДНО
N | PB9 | N | N |  |  |  |  |  | PB9
N | PB7 | N | SDA |  |  |  |  |  | PB7 | SDA
N | PB4 | Ctr13 | N |  |  |  |  |  | PB4 | CTRL
GND | GND | GND | GND |  |  |  |  |  | GND | GND | GND | GND | GND
N | PA5 | N | N |  |  |  |  |  | PA5
RF.TX | PA3 | N | N |  |  |  |  |  | PA3 | RX
RF.RX | PA2 | N | N |  |  |  |  |  | PA2 | TX
N | PA0 | Ctr15 | N |  |  |  |  |  | PA0 | CTRL
+5.0V | +5.0V | +5.0V | +5.0V |  |  |  |  |  | +5.0V | +5.0V | +5.0V | +5.0V | +5.0V
N | PC1 | N | SR.L |  |  |  |  |  | PC1 | SR-Latch
N | PC0 | N | MUX.O |  |  |  |  |  | PC0 | MUX_OUT
+Vbat | +Vbat | +Vbat | +Vbat |  |  |  |  |  | +Vbat | +Vbat | +Vbat | +Vbat | +Vbat
N | PB8 | N | N |  |  |  |  |  | PB8
N | PB6 | N | SCL |  |  |  |  |  | PB6 | SCL
N | PB5 | Ctr14 | N |  |  |  |  |  | PB5 | CTRL
+3.3V | +3.3V | +3.3v | +3.3V |  |  |  |  |  | +3.3V | +3.3V | +3.3V | +3.3v | +3.3V
+3.3V | +3.3V | +3.3v | +3.3V |  |  |  |  |  | +3.3V | +3.3V | +3.3V | +3.3v | +3.3V
N | PA7 | N | N |  |  |  |  |  | PA7
SR.OE | PC5 | N | N |  |  |  |  |  | PC5
N | PB1 | Ctr12 | N |  |  |  |  |  | PB1 | CTRL
+Vbat | +Vbat | +Vbat | +Vbat |  |  |  |  |  | +Vbat | +Vbat | +Vbat | +Vbat | +Vbat
G.PPS | PB10 | N | N |  |  |  |  |  | PB10 | LED/GNSS_PPS
SCK | PB13 | N | SCK |  |  |  |  |  | PB13 | SCK
+5.0V | +5.0V | +5.0V | +5.0V |  |  |  |  |  | +5.0V | +5.0V | +5.0V | +5.0V | +5.0V
MOSI | PB15 | N | MOSI |  |  |  |  |  | PB15 | MOSI
G.TX | PC7 | N | N |  |  |  |  |  | PC7 | RX
N | PA9 | N | N |  |  |  |  |  | PA9
N | PA10 | N | N |  |  |  |  |  | PA10
GND | GND | GND | GND |  |  |  |  |  | GND | GND | GND | GND | GND
N | PA6 | N | N |  |  |  |  |  | PA6
SR.L | PC4 | N | N |  |  |  |  |  | PC4 | SR_Latch
N | PB0 | Ctr11 | N |  |  |  |  |  | PB0 | CTRL
GND | GND | GND | GND |  |  |  |  |  | GND | GND | GND | GND | GND
N | PB2 | N | PE.INT |  |  |  |  |  | PB2 | PE_nINT
N | PB12 | N | N |  |  |  |  |  | PB12
GND | GND | GND | GND |  |  |  |  |  | GND | GND | GND | GND | GND
MISO | PB14 | N | MISO |  |  |  |  |  | PB14 | MISO
G.RX | PC6 | N | N |  |  |  |  |  | PC6 | TX
N | PA8 | N | N |  |  |  |  |  | PA8
GND | GND | GND | GND |  |  |  |  |  | GND | GND | GND | GND | GND

Sheet: GENERAL
MCU | RF-GNSS | PWR | IMU |  | RF-GNSS | MCU | PWR | IMU | User: |  | RF-GNSS | MCU |  | PWR | MCU | IMU | MCU
+3.3V | +3.3V | +3.3v | +3.3V | +3.3V | +3.3V |  |  |  | PA4 |  | G.PPS | PB10 |  | Ctr11 | PB0 | 1W | PA1
+3.3V | +3.3V | +3.3v | +3.3V | +3.3V |  |  |  |  | PA5 |  | G.RX | PC6 |  | Ctr12 | PB1 | PE.INT | PB2
+5.0V | +5.0V | +5.0V | +5.0V | +5.0V | +5.0V |  |  |  | PA6 |  | G.TX | PC7 |  | Ctr13 | PB4 | SCL | PB6
+5.0V | +5.0V | +5.0V | +5.0V | +5.0V |  |  |  |  | PA7 |  | MISO | PB14 |  | Ctr14 | PB5 | SDA | PB7
+Vbat | +Vbat | +Vbat | +Vbat | +Vbat | +Vbat |  |  |  | PA8 |  | MOSI | PB15 |  | Ctr15 | PA0 | SCK | PB13
+Vbat | +Vbat | +Vbat | +Vbat | +Vbat |  |  |  |  | PA9 |  | RF.AUX | PC3 |  |  |  | MISO | PB14
GND | GND | GND | GND | GND | GND |  |  |  | PA10 |  | RF.IRQ | PC2 |  |  |  | MOSI | PB15
GND | GND | GND | GND | GND |  |  |  |  | PB8 |  | RF.RX | PA2 |  |  |  | MUX.O | PC0
GND | GND | GND | GND | GND |  |  |  |  | PB9 |  | RF.TX | PA3 |  |  |  | SR.L | PC1
GND | GND | GND | GND | GND |  |  |  |  | PB12 |  | SCK | PB13 |  |  |  | SR.OE | PC13
GND | GND | GND | GND | GND |  |  |  |  |  |  | SR.L | PC4
GND | GND | GND | GND | GND |  |  |  |  |  |  | SR.nOE | PC5
GND | GND | GND | GND | GND
GND | GND | GND | GND | GND
PA0 | N | Ctr15 | N | PA0 | CTRL
PA1 | N | N | 1W | PA1 | 1-Wire
PA2 | RF.RX | N | N | PA2 | TX |  |  |  |  | SUPPLY | SPI | I2C | UART
PA3 | RF.TX | N | N | PA3 | RX |  |  |  |  | GND | SCK | SDA | RX | ADC
PA4 | N | N | N | PA4 | Free |  |  |  |  | 3V3 | MISO | SCL | TX | PWM
PA5 | N | N | N | PA5 | Free |  |  |  |  | 5V | MOSI | 1-Wire | CK | INT
PA6 | N | N | N | PA6 | Free |  |  |  |  | Vbat | NSS
PA7 | N | N | N | PA7 | Free
PA8 | N | N | N | PA8 | Free
PA9 | N | N | N | PA9 | Free
PA10 | N | N | N | PA10 | Free
PB0 | N | Ctr11 | N | PB0 | CTRL
PB1 | N | Ctr12 | N | PB1 | CTRL
PB2 | N | N | PE.INT | PB2 | PE_nINT
PB4 | N | Ctr13 | N | PB4 | CTRL
PB5 | N | Ctr14 | N | PB5 | CTRL
PB6 | N | N | SCL | PB6 | SCL
PB7 | N | N | SDA | PB7 | SDA
PB8 | N | N | N | PB8 | Free
PB9 | N | N | N | PB9 | Free
PB10 | G.PPS | N | N | PB10 | LED/GNSS_PPS
PB12 | N | N | N | PB12 | Free
PB13 | SCK | N | SCK | PB13 | SCK
PB14 | MISO | N | MISO | PB14 | MISO
PB15 | MOSI | N | MOSI | PB15 | MOSI
PC0 | N | N | MUX.O | PC0 | MUX_OUT
PC1 | N | N | SR.L | PC1 | SR-Latch
PC2 | RF.IRQ | N | N | PC2 | ADC
PC3 | RF.AUX | N | N | PC3 | ADC
PC4 | SR.L | N | N | PC4 | SR_Latch
PC5 | SR.nOE | N | N | PC5 | SR.nOE
PC6 | G.RX | N | N | PC6 | TX
PC7 | G.TX | N | N | PC7 | RX
PC13 | N | N | SR.OE | PC13 | SR-nOE

Sheet: SENSORS
Free
MCU L | MCU R | User | Bus | Pin |  | Default | Bus | SPI |  |  | SDIO |  | 1WIRE | UART
PA4 | PA6 | Dosimeter | GPIO | PA4 |  | ATGM336H | UART | SCK | PB13 |  | DAT0 | PC8 | PA1 | RX | PC7
PA5 | PA7 | Switch | GPIO | PA7 |  | LSM6DSL | SPI | MISO | PB14 |  | DAT1 | PC9 |  | TX | PC6
PB8 | PA8 | Buzzer | GPIO | PA8 |  | LIS3MDL | SPI | MOSI | PB15 |  | DAT2 | PC10
PB9 | PA9 | Incinerator | GPIO | PA9 | 2000, 300 | BMP280 | SPI |  |  |  | DAT3 | PC11
 | PA10 | Photoresistor (primary) | ADC | PA5 | 2000, 500 | DS18B20U | 1WIRE |  |  |  | CK | PC12
 | PB12 | Photoresistor (seed-checker) | ADC | PA6 |  | SD-card | SDIO |  |  |  | CMD | PD2
 |  |  |  |  |  | E01-ML01SP4 | SPI |  |  |  | CD | PA15
 |  |  |  |  | --help |  |  | ShiftReg | IMU | RF-GNSS
 |  |  |  |  | GNSS | ATGM336H |  | Latch | PC1 | PC4
 |  |  |  |  | A, ω | LSM6DSL |  | OE | PC13 | PC5
 |  |  |  |  | MAG | LIS3MDL
 |  |  |  |  | P | BMP280
 |  |  |  |  | T | DS18B20U
 |  |  |  |  |  | SD-card
 |  |  |  |  | RADIO | E01-ML01SP4
