cansat-tsniimash/CanSat-KT315-2022/Code/main_project/main_project.ioc

Mcu.UserName=STM32F401RCTx
PA10.Signal=USART1_RX
PA13.Signal=SYS_JTMS-SWDIO
PA14.Signal=SYS_JTCK-SWCLK
PA15.Signal=GPXTI15
PA4.GPIO_Label=Dosimeter
PA4.Signal=GPXTI4
PA5.GPIO_Label=Photo_rocket
PA5.Signal=ADCx_IN5
PA6.GPIO_Label=Photo_seed
PA6.Signal=ADCx_IN6
PA7.GPIO_Label=Switch
PA7.Signal=GPIO_Input
PA8.GPIO_Label=Buzzer
PA8.Signal=GPIO_Output
PA9.GPIO_Label=Incinerator
PA9.Signal=GPIO_Output
PB13.Signal=SPI2_SCK
PB14.Signal=SPI2_MISO
PB15.Signal=SPI2_MOSI
PB6.Signal=USART1_TX
PC1.Signal=GPIO_Output
PC10.Signal=SDIO_D2
PC11.Signal=SDIO_D3
PC12.Signal=SDIO_CK
PC13-ANTI_TAMP.Signal=GPIO_Output
PC14-OSC32_IN.Signal=RCC_OSC32_IN
PC15-OSC32_OUT.Signal=RCC_OSC32_OUT
PC4.Signal=GPIO_Output
PC5.Signal=GPIO_Output
PC6.Signal=USART6_TX
PC7.Signal=USART6_RX
PC8.Signal=SDIO_D0
PC9.Signal=SDIO_D1
PD2.Signal=SDIO_CMD
