cansat-tsniimash/CanSat-KT315-2022/Research/SDCARD_SPI_F103/Core/Src/main.c

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
/* Includes ------------------------------------------------------------------*/
#include "main.h"
#include "fatfs.h"

/* USER CODE BEGIN Includes */
#include "fatfs_sd.h"
#include "string.h"
#include "stdio.h"
/* USER CODE END Includes */

SPI_HandleTypeDef hspi1;

UART_HandleTypeDef huart1;

void SystemClock_Config(void);
static void MX_GPIO_Init(void);
static void MX_SPI1_Init(void);
static void MX_USART1_UART_Init(void);
/* USER CODE BEGIN 0 */

FATFS fs;  // file system
FIL fil; // File
FILINFO fno;
FRESULT fresult;  // result
UINT br, bw;  // File read/write count

/**** capacity related *****/
FATFS *pfs;
DWORD fre_clust;
uint32_t total, free_space;

#define BUFFER_SIZE 128
char buffer[BUFFER_SIZE];  // to store strings..

int i=0;

int bufsize (char *buf)
{
	int i=0;
	while (*buf++ != '\0') i++;
	return i;
}

void clear_buffer (void)
{
	for (int i=0; i<BUFFER_SIZE; i++) buffer[i] = '\0';
}

void send_uart (char *string)
{
	uint8_t len = strlen (string);
	HAL_UART_Transmit(&huart1, (uint8_t *) string, len, HAL_MAX_DELAY);  // transmit in blocking mode
}


/* USER CODE END 0 */

/**
  * @brief  The application entry point.
  * @retval int
  */
int main(void)
{
  /* MCU Configuration--------------------------------------------------------*/

  /* Reset of all peripherals, Initializes the Flash interface and the Systick. */
  HAL_Init();

  /* Configure the system clock */
  SystemClock_Config();

  /* Initialize all configured peripherals */
  MX_GPIO_Init();
  MX_SPI1_Init();
  MX_USART1_UART_Init();
  MX_FATFS_Init();
  /* USER CODE BEGIN 2 */

  HAL_Delay (500);

	fresult = f_mount(&fs, "/", 1);
  	if (fresult != FR_OK) send_uart ("ERROR!!! in mounting SD CARD...\n\n");
  	else send_uart("SD CARD mounted successfully...\n\n");


  	/*************** Card capacity details ********************/

  	/* Check free space */
  	f_getfree("", &fre_clust, &pfs);

  	total = (uint32_t)((pfs->n_fatent - 2) * pfs->csize * 0.5);
  	sprintf (buffer, "SD CARD Total Size: \t%lu\n",total);
  	send_uart(buffer);
  	clear_buffer();
  	free_space = (uint32_t)(fre_clust * pfs->csize * 0.5);
  	sprintf (buffer, "SD CARD Free Space: \t%lu\n\n",free_space);
  	send_uart(buffer);
  	clear_buffer();



  	/************* The following operation is using PUTS and GETS *********************/
  	// puts и gets передают в файл строку, в отличие от write и read
  	/* Open file to write/ create a file if it doesn't exist */
      fresult = f_open(&fil, "file1.txt", FA_OPEN_ALWAYS | FA_READ | FA_WRITE);

  	/* Writing text */
  	f_puts("This data is from the FILE1.txt. And it was written using ...f_puts... ", &fil);

  	/* Close file */
  	fresult = f_close(&fil);

  	if (fresult == FR_OK)send_uart ("File1.txt created and the data is written \n");

  	/* Open file to read */
  	fresult = f_open(&fil, "file1.txt", FA_READ);

  	/* Read string from the file */
  	f_gets(buffer, f_size(&fil), &fil);

  	send_uart("File1.txt is opened and it contains the data as shown below\n");
  	send_uart(buffer);
  	send_uart("\n\n");

  	/* Close file */
  	f_close(&fil);

  	clear_buffer();




  	/**************** The following operation is using f_write and f_read **************************/
  	// write и read передают (получают) в файл массив, в отличие от puts и gets
  	/* Create second file with read write access and open it */
  	fresult = f_open(&fil, "file2.txt", FA_CREATE_ALWAYS | FA_WRITE);

  	/* Writing text */
  	strcpy (buffer, "This is File2.txt, written using ...f_write... and it says Hello from Controllerstech\n");

  	fresult = f_write(&fil, buffer, bufsize(buffer), &bw);

  	send_uart ("File2.txt created and data is written\n");

  	/* Close file */
  	f_close(&fil);



  	// clearing buffer to show that result obtained is from the file
  	clear_buffer();

  	/* Open second file to read */
  	fresult = f_open(&fil, "file2.txt", FA_READ);
  	if (fresult == FR_OK)send_uart ("file2.txt is open and the data is shown below\n");

  	/* Read data from the file
  	 * Please see the function details for the arguments */
  	f_read (&fil, buffer, f_size(&fil), &br);
  	send_uart(buffer);
  	send_uart("\n\n");

  	/* Close file */
  	f_close(&fil);

  	clear_buffer();


  	/*********************UPDATING an existing file ***************************/

  	/* Open the file with write access */
  	fresult = f_open(&fil, "file2.txt", FA_OPEN_EXISTING | FA_READ | FA_WRITE);

  	/* Move to offset to the end of the file */
  	fresult = f_lseek(&fil, f_size(&fil));

  	if (fresult == FR_OK)send_uart ("About to update the file2.txt\n");

  	/* write the string to the file */
  	fresult = f_puts("This is updated data and it should be in the end", &fil);

  	f_close (&fil);

  	clear_buffer();

  	/* Open to read the file */
  	fresult = f_open (&fil, "file2.txt", FA_READ);

  	/* Read string from the file */
  	fresult = f_read (&fil, buffer, f_size(&fil), &br);
  	if (fresult == FR_OK)send_uart ("Below is the data from updated file2.txt\n");
  	send_uart(buffer);
  	send_uart("\n\n");

  	/* Close file */
  	f_close(&fil);

  	clear_buffer();


  	/*************************REMOVING FILES FROM THE DIRECTORY ****************************/

  	fresult = f_unlink("/file1.txt");
  	if (fresult == FR_OK) send_uart("file1.txt removed successfully...\n");

    fresult = f_unlink("/file2.txt");
  	if (fresult == FR_OK) send_uart("file2.txt removed successfully...\n");

  	/* Unmount SDCARD */
  	fresult = f_mount(NULL, "/", 1);
  	if (fresult == FR_OK) send_uart ("SD CARD UNMOUNTED successfully...\n");


  /* USER CODE END 2 */

  /* Infinite loop */
  /* USER CODE BEGIN WHILE */
  while (1)
  {
    /* USER CODE END WHILE */

    /* USER CODE BEGIN 3 */
  }
  /* USER CODE END 3 */
}

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
