cansat-tsniimash/CanSat-KT315-2022/Code/main_project/Application/Src/sd.c

#include <sd.h>
#include <inttypes.h>
#include <includes.h>

#include <timers.h>
extern uint32_t sd_reboot_timer;

#include <radio.h>

void update_status_in_defaults(FATFS* file_system, FIL* file, const char* path, UINT* bytes_written, sd_defaults_crc_t *data, uint8_t status, uint8_t reboot_count) {
	data->pack.status = status;
	data->pack.reboot_counter = reboot_count;
	data->crc = Crc16((uint8_t*)&data->pack, sizeof(data->pack));
	file_open(file_system, file, path, FA_WRITE | FA_CREATE_ALWAYS);
	file_write(file_system, file, path, data, sizeof(*data), bytes_written);
	file_sync(file_system, file, path);
	f_close(file);
}

uint16_t sd_parse_to_bytes_dosimeter(char *buffer, rf_dosimeter_package_crc_t *data) {
	memset(buffer, 0, 300);
	uint16_t num_written = snprintf(
			buffer, 300,
			"%d;%"PRIu16";%"PRIu32";%"PRIu32";%"PRIu32";%"PRIu32";%"PRIu16"\n",
			data->pack.flag, data->pack.num, data->pack.time_from_start,
			data->pack.ticks_per_last_second, data->pack.ticks_per_last_minute, data->pack.ticks_sum,
			data->crc);
	return num_written;
}

uint16_t sd_parse_to_bytes_bmp(char *buffer, rf_bmp_package_crc_t *data) {
	memset(buffer, 0, 300);
	uint16_t num_written = snprintf(
			buffer, 300,
			"%d;%"PRIu16";%"PRIu32";%f;%f;%d;%"PRIu16"\n",
			data->pack.flag, data->pack.num, data->pack.time_from_start,
			data->pack.bmp_temperature, data->pack.bmp_pressure,
			data->pack.status,
			data->crc);
	return num_written;
}

uint16_t sd_parse_to_bytes_ds(char *buffer, rf_ds_package_crc_t *data) {
	memset(buffer, 0, 300);
	uint16_t num_written = snprintf(
			buffer, 300,
			"%d;%"PRIu16";%"PRIu32";%f;%f;%f;%"PRIu16"\n",
			data->pack.flag, data->pack.num, data->pack.time_from_start,
			data->pack.ds18b20_temperature,
			data->pack.rocket_lux, data->pack.seed_lux,
			data->crc);
	return num_written;
}

uint16_t sd_parse_to_bytes_gps(char *buffer, rf_gps_package_crc_t *data, uint64_t time_s) {
	memset(buffer, 0, 300);
	uint32_t time_sec_high = time_s >> (4 * 8);
	uint32_t time_sec_low = time_s & 0xFFFFFFFF;
	uint16_t num_written = snprintf(
			buffer, 300,
			"%d;%"PRIu16";%"PRIu32";%f;%f;%f;%"PRIu32";%"PRIu32";%"PRIu32";%d;%"PRIu16"\n",
			data->pack.flag, data->pack.num, data->pack.time_from_start,
			data->pack.longtitude, data->pack.latitude, data->pack.altitude,
			time_sec_high, time_sec_low, data->pack.time_microsec,
			data->pack.fix,
			data->crc);
	return num_written;
}

uint16_t sd_parse_to_bytes_inertial(char *buffer, rf_inertial_package_crc_t *data, float lsm_acc [3], float lsm_gyro [3], float lis_mag [3]) {
	memset(buffer, 0, 300);
	uint16_t num_written = snprintf(
			buffer, 300,
			"%d;%"PRIu16";%"PRIu32";%f;%f;%f;%f;%f;%f;%f;%f;%f;%"PRIu16"\n",
			data->pack.flag, data->pack.num, data->pack.time_from_start,
			lsm_acc[0], lsm_acc[1], lsm_acc[2],
			lsm_gyro[0], lsm_gyro[1], lsm_gyro[2],
			lis_mag[0], lis_mag[1], lis_mag[2],
			data->crc);
	return num_written;
}

uint16_t sd_parse_to_bytes_sebastian(char *buffer, rf_sebastian_package_crc_t *data) {
	memset(buffer, 0, 300);
	uint16_t num_written = snprintf(
			buffer, 300,
			"%d;%"PRIu16";%"PRIu32";%f;%f;%f;%f;%"PRIu16"\n",
			data->pack.flag, data->pack.num, data->pack.time_from_start,
			data->pack.quaternion[0], data->pack.quaternion[1], data->pack.quaternion[2], data->pack.quaternion[3],
			data->crc);
	return num_written;
}

static void system_reset(void) {
	if (0 == sd_reboot_timer) {
		timer_update_sd_reboot();
		HAL_GPIO_WritePin(Buzzer_GPIO_Port, Buzzer_Pin, 1);
	} else {
		if (HAL_GetTick() - sd_reboot_timer > SD_REBOOT_DELAY) {
			NVIC_SystemReset();
		}
	}
	return;
}

void file_system_mount(FATFS* file_system) {
	FRESULT fres = 0;
	extern Disk_drvTypeDef disk;
	disk.is_initialized[0] = 0;
	fres = f_mount(file_system, "", 1);
	if (FR_OK != fres) {
		system_reset();
	}
	return;
}

void file_open(FATFS* file_system, FIL* file, const char* path, BYTE mode) {
	FRESULT fres = 0;
	fres = f_open(file, path, mode);
	if (FR_OK != fres) {
		f_mount(NULL, "", 1);
		file_system_mount(file_system);
		fres = f_open(file, path, mode);
		if (FR_OK != fres) {
			system_reset();
		}
	}
	return;
}

void file_read(FATFS* file_system, FIL* file, const char* path, void* buffer, uint16_t bytes_to_read, UINT* bytes_read) {
	FRESULT fres = 0;
	fres = f_read(file, buffer, bytes_to_read, bytes_read);
	if (FR_OK != fres) {
		f_close(file);
		file_open(file_system, file, path, FA_READ | FA_OPEN_EXISTING);
		fres = f_read(file, buffer, bytes_to_read, bytes_read);
		if (FR_OK != fres) {
			f_mount(NULL, "", 1);
			file_system_mount(file_system);
			file_open(file_system, file, path, FA_READ | FA_OPEN_EXISTING);
			fres = f_read(file, buffer, bytes_to_read, bytes_read);
			if (FR_OK != fres) {
				system_reset();
			}
		}
	}
	return;
}

void file_puts(FATFS* file_system, FIL* file, const char* path, const char* str) {
	int fres = 0;
	fres = f_puts(str, file);
	if (0 > fres) {
		f_close(file);
		file_open(file_system, file, path, FA_WRITE | FA_OPEN_APPEND);
		fres = f_puts(str, file);
		if (0 > fres) {
			f_mount(NULL, "", 1);
			file_system_mount(file_system);
			file_open(file_system, file, path, FA_WRITE | FA_OPEN_APPEND);
			fres = f_puts(str, file);
			if (0 > fres) {
				system_reset();
			} else {
				f_puts("remounted, file error fixed\n", file);
			}
		} else {
			f_puts("reopened, file error fixed\n", file);
		}
	}
	return;
}

void file_write(FATFS* file_system, FIL* file, const char* path, void* buffer, uint16_t buffer_size, UINT* bytes_written) {
	FRESULT fres = 0;
	fres = f_write(file, buffer, buffer_size, bytes_written);
	if (FR_OK != fres) {
		f_close(file);
		file_open(file_system, file, path, FA_WRITE | FA_OPEN_APPEND);
		fres = f_write(file, buffer, buffer_size, bytes_written);
		if (FR_OK != fres) {
			f_mount(NULL, "", 1);
			file_system_mount(file_system);
			file_open(file_system, file, path, FA_WRITE | FA_OPEN_APPEND);
			fres = f_write(file, buffer, buffer_size, bytes_written);
			if (FR_OK != fres) {
				system_reset();
			} else {
				file_puts(file_system, file, path, "remounted, file error fixed\n");
			}
		} else {
			file_puts(file_system, file, path, "reopened, file error fixed\n");
		}
	}
	return;
}

void file_sync(FATFS* file_system, FIL* file, const char* path) {
	FRESULT fres = 0;
	fres = f_sync(file);
	if (FR_OK != fres) {
		f_close(file);
		f_mount(NULL, "", 1);
		file_system_mount(file_system);
		file_open(file_system, file, path, FA_WRITE | FA_OPEN_APPEND);
		file_puts(file_system, file, path, "reopened, file error fixed\n");
	}
	return;
}
