cansat-tsniimash/CanSat-KT315-2022/Code/main_project/Application/Src/radio.c

#include <radio.h>
#include <includes.h>

static uint16_t package_num_dosimeter = 0;
static uint16_t package_num_bmp = 0;
static uint16_t package_num_ds = 0;
static uint16_t package_num_gps = 0;
static uint16_t package_num_inertial = 0;
static uint16_t package_num_sebastian = 0;

uint16_t Crc16(uint8_t *buf, uint16_t len) {
	uint16_t crc = 0xFFFF;
	uint8_t i;
	while (len--) {
		crc ^= *buf++ << 8;
		for (i = 0; i < 8; i++)
			crc = crc & 0x8000 ? (crc << 1) ^ 0x1021 : crc << 1;
	}
	return crc;
}


nrf24_spi_pins_sr_t nrf24_create_sr_descriptor(shift_reg_t *shift_reg, uint8_t pos_CE, uint8_t pos_CS) {
	nrf24_spi_pins_sr_t nrf_sr_ = {
		.this = shift_reg,
		.pos_CE = pos_CE,
		.pos_CS = pos_CS
	};
	return nrf_sr_;
}

nrf24_rf_config_t nrf24_create_rf_descriptor(nrf24_data_rate_t data_rate, nrf24_tx_power_t tx_power, uint8_t rf_channel) {
	nrf24_rf_config_t nrf_rf_ = {
		.data_rate = data_rate,
		.tx_power = tx_power,
		.rf_channel = rf_channel
	};
	return nrf_rf_;
}

nrf24_protocol_config_t nrf24_create_protocol_descriptor(nrf24_crc_size_t crc_size, nrf24_address_width_t address_width, bool en_dyn_payload_size, bool en_ack_payload, bool en_dyn_ack, uint8_t auto_retransmit_count, uint8_t auto_retransmit_delay) {
	nrf24_protocol_config_t nrf_protocol_ = {
		.crc_size = crc_size,
		.address_width = address_width,
		.en_dyn_payload_size = en_dyn_payload_size,
		.en_ack_payload = en_ack_payload,
		.en_dyn_ack = en_dyn_ack,
		.auto_retransmit_count = auto_retransmit_count,
		.auto_retransmit_delay = auto_retransmit_delay
	};
	return nrf_protocol_;
}

nrf24_pipe_config_t nrf24_create_pipe_descriptor(bool enable_auto_ack, uint64_t address, int8_t payload_size) {
	nrf24_pipe_config_t nrf_pipe_ = {
		.enable_auto_ack = enable_auto_ack,
		.address = address,
		.payload_size = payload_size
	};
	return nrf_pipe_;
}

void nrf24_init_stm32(nrf24_lower_api_config_t *nrf24_config_, SPI_HandleTypeDef *bus, nrf24_spi_pins_sr_t *nrf24_sr_setup_, nrf24_rf_config_t *nrf24_rf_setup_, nrf24_protocol_config_t *nrf24_protocol_setup_, nrf24_pipe_config_t *nrf24_pipe_setup_) {
	nrf24_spi_init_sr(nrf24_config_, bus, nrf24_sr_setup_);
	nrf24_mode_standby(nrf24_config_);
	nrf24_setup_rf(nrf24_config_, nrf24_rf_setup_);
	nrf24_setup_protocol(nrf24_config_, nrf24_protocol_setup_);
	nrf24_pipe_set_tx_addr(nrf24_config_, 0xacacacacac);
	nrf24_pipe_rx_start(nrf24_config_, 0, nrf24_pipe_setup_);
	nrf24_pipe_rx_start(nrf24_config_, 1, nrf24_pipe_setup_);
	nrf24_mode_standby(nrf24_config_);
	nrf24_fifo_flush_tx(nrf24_config_);
	return;
}



rf_dosimeter_package_crc_t pack_rf_dosimeter(uint32_t ticks_per_last_sec, uint32_t ticks_per_last_minute, uint32_t ticks_sum) {
	rf_dosimeter_package_t rf_package_ = {
		.flag = RF_FLAG_DOSIMETER,
		.num = package_num_dosimeter,
		.time_from_start = HAL_GetTick(),
		.ticks_per_last_second = ticks_per_last_sec,
		.ticks_per_last_minute = ticks_per_last_minute,
		.ticks_sum = ticks_sum
	};
	rf_dosimeter_package_crc_t rf_package_crc_ = {
		.pack = rf_package_,
		.crc = Crc16((uint8_t*)&rf_package_, sizeof(rf_package_))
	};
	package_num_dosimeter++;
	return rf_package_crc_;
}

rf_bmp_package_crc_t pack_rf_bmp(double temperature, double pressure, uint8_t status) {
	rf_bmp_package_t rf_package_ = {
		.flag = RF_FLAG_BMP,
		.num = package_num_bmp,
		.time_from_start = HAL_GetTick(),
		.bmp_temperature = temperature,
		.bmp_pressure = pressure,
		.status = status
	};
	rf_bmp_package_crc_t rf_package_crc_ = {
		.pack = rf_package_,
		.crc = Crc16((uint8_t*)&rf_package_, sizeof(rf_package_))
	};
	package_num_bmp++;
	return rf_package_crc_;
}

rf_ds_package_crc_t pack_rf_ds(float temperature, float rckt_lux, float seed_lux) {
	rf_ds_package_t rf_package_ = {
		.flag = RF_FLAG_DS,
		.num = package_num_ds,
		.time_from_start = HAL_GetTick(),
		.ds18b20_temperature = temperature,
		.rocket_lux = rckt_lux,
		.seed_lux = seed_lux
	};
	rf_ds_package_crc_t rf_package_crc_ = {
		.pack = rf_package_,
		.crc = Crc16((uint8_t*)&rf_package_, sizeof(rf_package_))
	};
	package_num_ds++;
	return rf_package_crc_;
}

rf_gps_package_crc_t pack_rf_gps(float lon, float lat, float alt, uint32_t time_sec, uint32_t time_microsec, uint8_t fix) {
	rf_gps_package_t rf_package_ = {
		.flag = RF_FLAG_GPS,
		.num = package_num_gps,
		.time_from_start = HAL_GetTick(),
		.longtitude = lon,
		.latitude = lat,
		.altitude = alt,
		.time_sec = time_sec,
		.time_microsec = time_microsec,
		.fix = fix,
	};
	rf_gps_package_crc_t rf_package_crc_ = {
		.pack = rf_package_,
		.crc = Crc16((uint8_t*)&rf_package_, sizeof(rf_package_))
	};
	package_num_gps++;
	return rf_package_crc_;
}

rf_inertial_package_crc_t pack_rf_inertial(int16_t acc [3], int16_t gyro [3], int16_t mag [3]) {
	rf_inertial_package_t rf_package_ = {
		.flag = RF_FLAG_INERTIAL,
		.num = package_num_inertial,
		.time_from_start = HAL_GetTick(),
		.lsm_acc[0] = acc[0],
		.lsm_acc[1] = acc[1],
		.lsm_acc[2] = acc[2],
		.lsm_gyro[0] = gyro[0],
		.lsm_gyro[1] = gyro[1],
		.lsm_gyro[2] = gyro[2],
		.lis_mag[0] = mag[0],
		.lis_mag[1] = mag[1],
		.lis_mag[2] = mag[2],
	};
	rf_inertial_package_crc_t rf_package_crc_ = {
		.pack = rf_package_,
		.crc = Crc16((uint8_t*)&rf_package_, sizeof(rf_package_))
	};
	package_num_inertial++;
	return rf_package_crc_;
}

rf_sebastian_package_crc_t pack_rf_sebastian(float quaternion [4]) {
	rf_sebastian_package_t rf_package_ = {
		.flag = RF_FLAG_SEBASTIAN,
		.num = package_num_sebastian,
		.time_from_start = HAL_GetTick(),
		.quaternion[0] = quaternion[0],
		.quaternion[1] = quaternion[1],
		.quaternion[2] = quaternion[2],
		.quaternion[3] = quaternion[3],
	};
	rf_sebastian_package_crc_t rf_package_crc_ = {
		.pack = rf_package_,
		.crc = Crc16((uint8_t*)&rf_package_, sizeof(rf_package_))
	};
	package_num_sebastian++;
	return rf_package_crc_;
}



void send_rf_package(nrf24_service_t *nrf24_service, void *package, size_t size) {
	nrf24_fifo_status(nrf24_service->nrf24_lower_api_config, &nrf24_service->rf_fifo_status_rx, &nrf24_service->rf_fifo_status_tx);
	if (nrf24_service->rf_fifo_status_tx != NRF24_FIFO_FULL) {
		nrf24_fifo_write(nrf24_service->nrf24_lower_api_config, (uint8_t*) package, size, false);
		nrf24_mode_tx(nrf24_service->nrf24_lower_api_config);
		HAL_Delay(3);
		nrf24_mode_standby(nrf24_service->nrf24_lower_api_config);
	} else {
		nrf24_fifo_flush_tx(nrf24_service->nrf24_lower_api_config);
		HAL_Delay(100);
	}
	nrf24_irq_clear(nrf24_service->nrf24_lower_api_config, NRF24_IRQ_RX_DR | NRF24_IRQ_TX_DR | NRF24_IRQ_MAX_RT);
}
