cansat-tsniimash/CanSat-KT315-2022/Code/main_project/Application/status.h

#ifndef STATUS_H_
#define STATUS_H_

typedef enum {
	STATUS_BEFORE_ROCKET,
	STATUS_IN_ROCKET,
	STATUS_OUT_OF_ROCKET,
	STATUS_STABILISED,
	STATUS_STARTED_BURNING,
	STATUS_STRING_BURNT,
	STATUS_LANDED,
	STATUS_AFTER
} status_t;

#endif /* STATUS_H_ */
