cansat-tsniimash/CanSat-KT315-2022/Code/main_project/Application/includes.h

#ifndef INCLUDES_H_
#define INCLUDES_H_

#include <stdint.h>
#include <stdbool.h>
#include <stdio.h>
#include <string.h>
#include <stm32f4xx_hal.h>
#include <fatfs.h>

//#include <DWT_Delay/dwt_delay.h>
#include <Shift_Register/shift_reg.h>
#include <BME280/DriverForBME280.h>
#include <LSM6DS3/DLSM.h>
#include <LIS3MDL/DLIS3.h>
#include <ATGM336H/nmea_gps.h>
#include <1Wire_DS18B20/one_wire.h>
#include <Dosimeter/dosimeter.h>

#include <nRF24L01_PL/nrf24_upper_api.h>
#include <nRF24L01_PL/nrf24_lower_api.h>
#include <nRF24L01_PL/nrf24_lower_api_stm32.h>
#include <nRF24L01_PL/nrf24_defs.h>

#endif /* INCLUDES_H_ */
