cansat-tsniimash/CanSat-KT315-2022/(commit log)

2022-02-05 Тест дров сд-карты
2022-02-10 Добавили общую библиотеку
2022-02-10 Тест ссылок
2022-02-12 Кодик для ацп (фоторезистора)
2022-02-12 убрали лишнее
2022-02-12 updated photoresistor drivers, you can change channels now =(^_^)=
2022-02-16 убрал тесты
2022-03-02 поменял название папки с дровами карточки
2022-03-02 спёр код, буду чекать
2022-03-07 мануал
2022-03-16 Сабмодуль перехал на ssh
2022-03-16 Обновили сабмодуль до последней версии
2022-03-19 research projects
    [SDCARD_SPI_F103 Debug (1).cfg]
2022-03-22 ~~убрал лишний проект~~
2022-03-26 мучаем sd-карту
2022-03-28 пути до сабмодулей относительные
2022-04-06 docs and new project
    [constructor pinout.xlsx, конструктор-пины.xlsx]
2022-04-06 final project devices
    [constructor pinout.xlsx]
2022-04-23 smth strange
    [constructor pinout.xlsx]
2022-05-02 video project
    [constructor pinout.xlsx]
2022-05-08 радио работаааеееееетgit statusgit status!
2022-05-10 разгрёб проекты
2022-05-14 splitted code into million files
2022-05-25 принёс свой кодик домой ~~
2022-06-10 sd parsers done
    [constructor pinout.xlsx]
2022-06-10 started timers for ds18 and sd
2022-06-15 радио передаёт
2022-06-16 photores drivers done
2022-06-17 photoresistor drivers done (finally)
2022-06-17 сделал 4 пакета + таймеры, не работают доза и (возможно, не проверил нормально) фоторезы
2022-06-18 фоторезы работают, гпс не работает
    [constructor pinout.xlsx]
2022-06-18 added timer to dosimeter
2022-06-21 Правильное игнорирование директорий
2022-06-21 Добавил пин переключателей
    [constructor pinout.xlsx]
2022-06-21 статусы не робят (пережигалка не пережигает, пищалка пищит плохо)
    [constructor pinout.xlsx]
2022-06-22 gps робит (вроде как, на улицу не ходил)
2022-06-22 переписал сд (указатели вместо копий)
2022-06-25 пережига и буззер работают
2022-06-28 защита сд готова, тестов пока не было
2022-06-28 radio timers
2022-06-29 sd sec: dying after reboot
    [main_project Debug (1).cfg]
2022-06-29 gps работает
2022-06-30 вкрутил Маджвик + сделал отложенный ребут (сд)
    [main_project Debug (1).cfg]
2022-07-01 final version (i pray to God there is no bugs)
    [app_main.c, radio.c, radio.h, sd.c, sd.h, timers.c, timers.h]
2022-07-02 пофиксил лажу с дефолтами на сд, добавил счётчик ребутов
2022-07-02 вроде стабильная версия, помолитесь Богу за здравие кода
2022-07-02 собрал всякое-разное
    [constructor pinout.xlsx, erunda.stl, panki_xoi.stl, конструктор-пины.xlsx]
2022-07-07 телеметрия (и даже маджвик)
    [all_data.csv, input.csv, madgw.csv, model.stl, quat.csv, res.csv, result.csv]
